enggsajjad/coffeeMachine/BA/coffee/Thesis_Simon/presentation/hardware.tex

\begin{tikzpicture}
    \node[inner sep=0pt] (cm) at (0,0)
    {};
    \node[inner sep=0pt] (pi) at (5,0)
    {};
    \node[inner sep=0pt] (rfid) at (9,0)
    {};
    \node[inner sep=0pt,outer sep=2pt] (buzzer) at (5,-2.5)
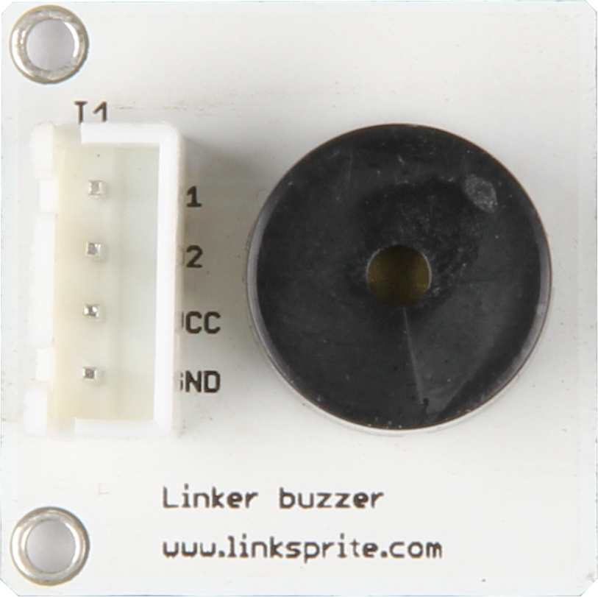
[picture p16: BA/coffee/Thesis_Simon/presentation/images/LK-Buzzer-1.png]
    {};
    \node[rectangle,draw] (tag) at (9,-2.0) {RFID tag};
    \node[inner sep=0pt] (touch) at (5,2.5)
    {};
    \node[inner sep=0pt] (screen) at (5,2.93)
    {};
    \node[rectangle,rounded corners,draw,fill=KITgreen50,align=center,outer sep=2pt] (server) at (9,2.5) {Accounting \\ Server};

    \path[thick,fill=green]
    (pi) edge [<-] node {} (rfid)
    edge [<->] node {} (touch)
    edge [->] node {} (buzzer)
    edge [<->] node[right=1mm] {HTTP} (server)
    edge [<->] node[fill=white,rectangle,draw,align=left] {Adapter \\ Board} (cm)
    (rfid) edge [<-] (tag)
    ;
\end{tikzpicture}
