enggsajjad/coffeeMachine/BA/beamer_template/preambel/cleverrefconfig.tex

\crefname{section}{Abschnitt}{Abschnitte}
\Crefname{section}{Abschnitt}{Abschnitte}

\crefname{subsection}{Unterabschnitt}{Unterabschnitte}
\Crefname{subsection}{Unterabschnitt}{Unterabschnitte}

\crefname{Def}{Definition}{Definitionen}
\Crefname{Def}{Definition}{Definitionen}
\crefname{Def_noBreak}{Definition}{Definitionen}
\Crefname{Def_noBreak}{Definition}{Definitionen}

\crefname{Bsp}{Beispiel}{Beispiele}
\Crefname{Bsp}{Beispiel}{Beispiele}
\crefname{Bsp_noBreak}{Beispiel}{Beispiele}
\Crefname{Bsp_noBreak}{Beispiel}{Beispiele}

\crefname{Bem}{Bemerkung}{Bemerkungen}
\Crefname{Bem}{Bemerkung}{Bemerkungen}
\crefname{Bem_noBreak}{Bemerkung}{Bemerkungen}
\Crefname{Bem_noBreak}{Bemerkung}{Bemerkungen}

\crefname{Sa}{Satz}{Sätze}
\Crefname{Sa}{Satz}{Sätze}
\crefname{Sa_noBreak}{Satz}{Sätze}
\Crefname{Sa_noBreak}{Satz}{Sätze}

\crefname{Lem}{Lemma}{Lemmata}
\Crefname{Lem}{Lemma}{Lemmata}
\crefname{Lem_noBreak}{Lemma}{Lemmata}
\Crefname{Lem_noBreak}{Lemma}{Lemmata}

\crefname{Ko}{Korollar}{Korollare}
\Crefname{Ko}{Korollar}{Korollare}
\crefname{Ko_noBreak}{Korollar}{Korollare}
\Crefname{Ko_noBreak}{Korollar}{Korollare}

\crefname{Erg}{Ergänzung}{Ergänzungen}
\Crefname{Erg}{Ergänzung}{Ergänzungen}
\crefname{Erg_noBreak}{Ergänzung}{Ergänzungen}
\Crefname{Erg_noBreak}{Ergänzung}{Ergänzungen}

\crefname{Bed}{Bedingung}{Bedingungen}
\Crefname{Bed}{Bedingung}{Bedingungen}
\crefformat{Bed}{Bedingung~(#2#1#3)}
\Crefformat{Bed}{Bedingung~(#2#1#3)}
\crefmultiformat{Bed}{Bedingungen~(#2#1#3)}
\Crefmultiformat{Bed}{Bedingungen~(#2#1#3)}
