enggsajjad/coffeeMachine/BA/coffee/Thesis_2017_Karim_Ben_Ammar/images/adapterraspberry.pdf

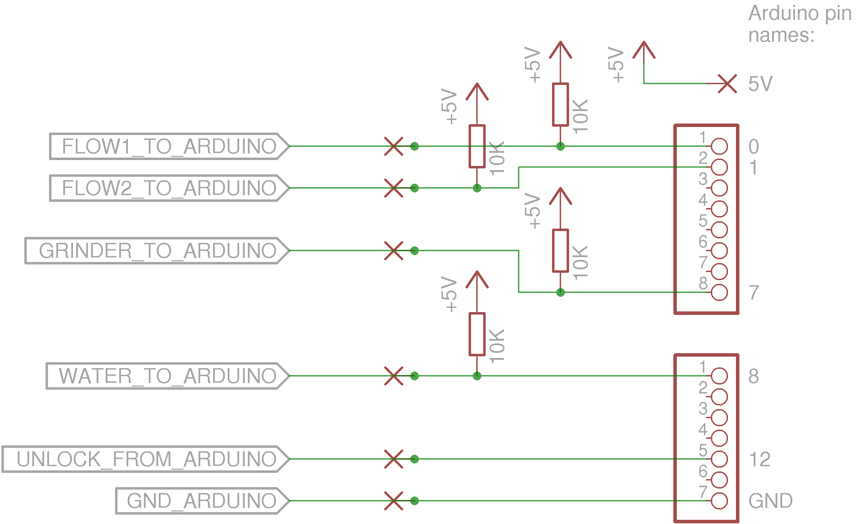
[picture p61: page 1]
