enggsajjad/coffeeMachine/BA/coffee/Thesis_2017_Karim_Ben_Ammar/images/case.pdf

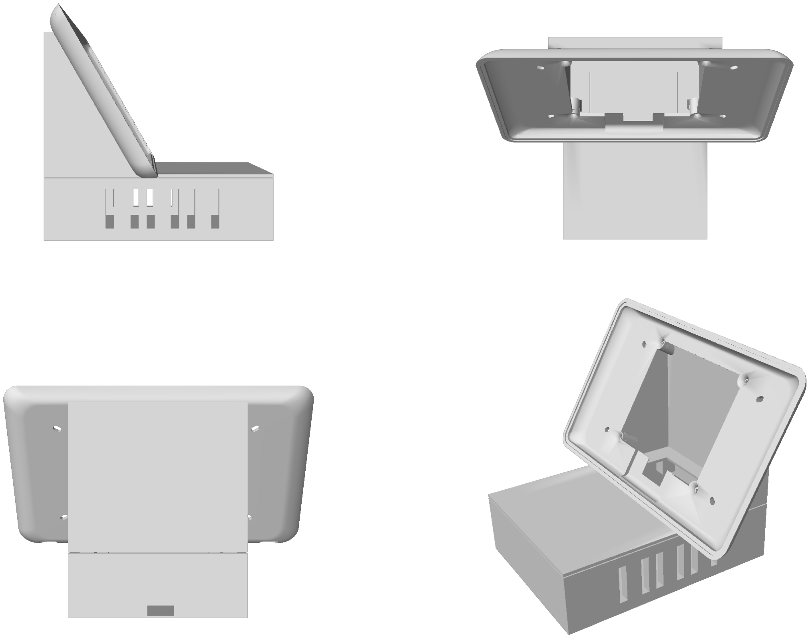
[picture p62: page 1]
