enggsajjad/coffeeMachine/BA/coffee/Thesis_2017_Karim_Ben_Ammar/images/offlineHandlerClasses.pdf

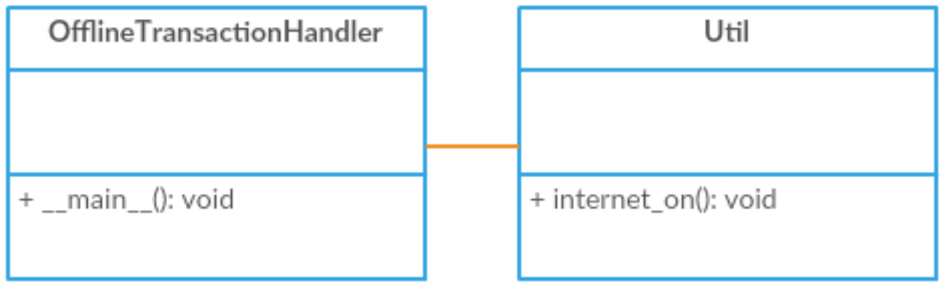
[picture p63: page 1]
