enggsajjad/coffeeMachine/BA/coffee/Thesis_2017_Karim_Ben_Ammar/images/oldPCBSchematic.pdf

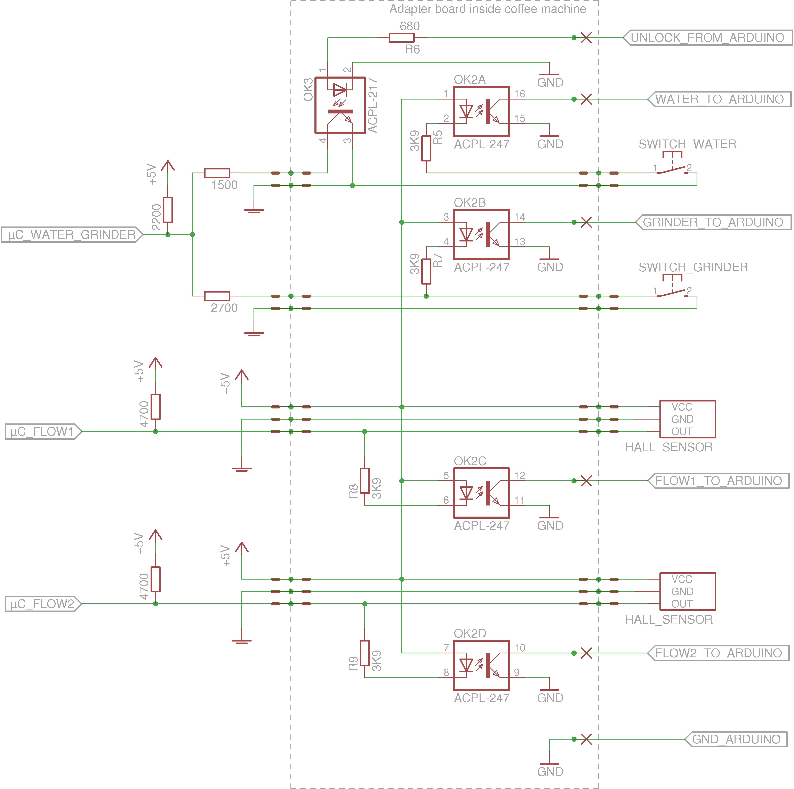
[picture p78: page 1]
