enggsajjad/coffeeMachine/BA/beamer_template/example/ces_title.jpg

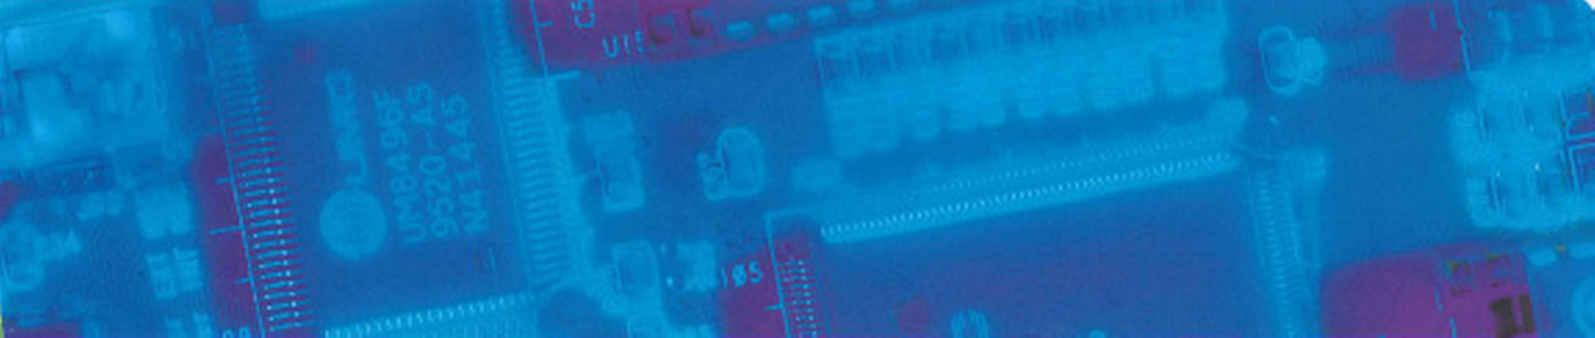
BA/beamer_template/example/ces_title.jpg
