enggsajjad/coffeeMachine/BA/coffee/Thesis_2017_Karim_Ben_Ammar/Code/res/2-sugars-app.jpeg

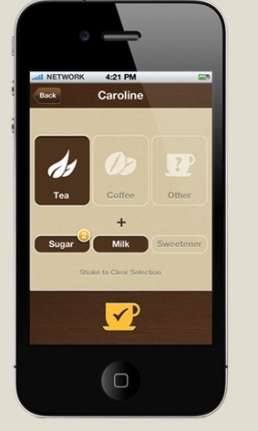
BA/coffee/Thesis_2017_Karim_Ben_Ammar/Code/res/2-sugars-app.jpeg
