enggsajjad/coffeeMachine/BA/coffee/Thesis_2017_Karim_Ben_Ammar/Code/res/check-box-button-clipart-vector-clip-art-online-free.png

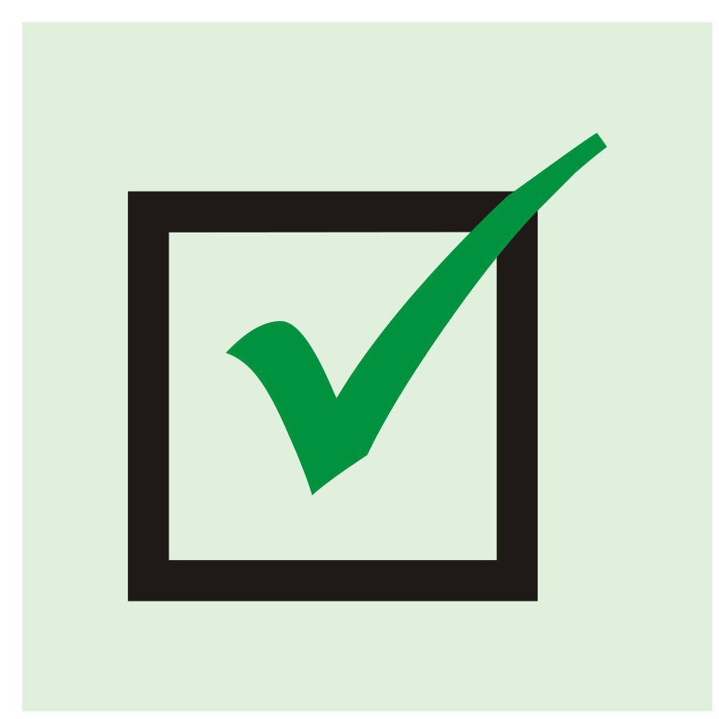
BA/coffee/Thesis_2017_Karim_Ben_Ammar/Code/res/check-box-button-clipart-vector-clip-art-online-free.png
