enggsajjad/coffeeMachine/BA/coffee/Thesis_2017_Karim_Ben_Ammar/Code/res/euro-big-coin-on-a-small-hand_318-37493.jpg

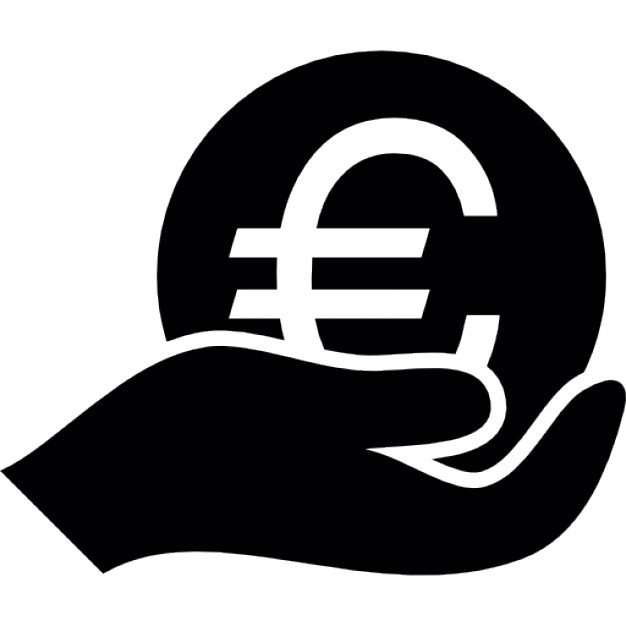
BA/coffee/Thesis_2017_Karim_Ben_Ammar/Code/res/euro-big-coin-on-a-small-hand_318-37493.jpg
