enggsajjad/coffeeMachine/BA/coffee/Thesis_2017_Karim_Ben_Ammar/Code/res/funny-comic-smartphones-1024x951.jpg

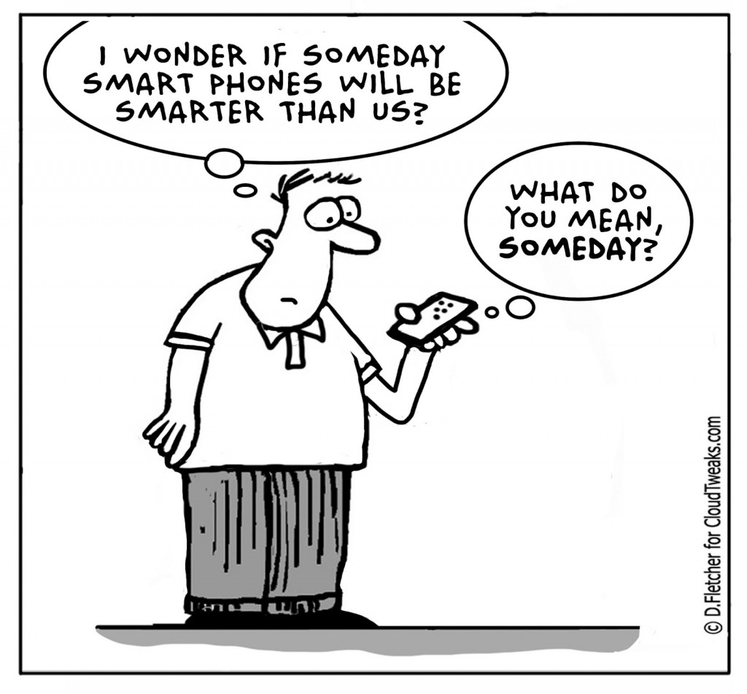
BA/coffee/Thesis_2017_Karim_Ben_Ammar/Code/res/funny-comic-smartphones-1024x951.jpg
