enggsajjad/coffeeMachine/BA/coffee/Thesis_2017_Karim_Ben_Ammar/Code/res/panda_sprite_by_balvick-d7qrors.png

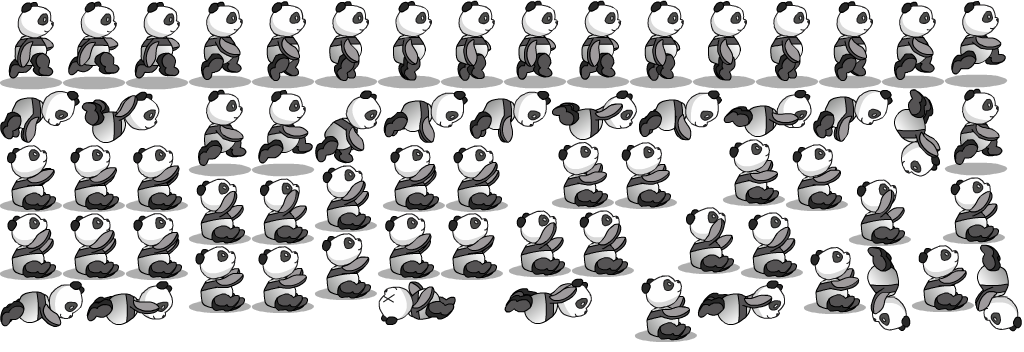
BA/coffee/Thesis_2017_Karim_Ben_Ammar/Code/res/panda_sprite_by_balvick-d7qrors.png
