enggsajjad/coffeeMachine/BA/coffee/Thesis_2017_Karim_Ben_Ammar/Code/res/water-drop-in-a-rounded-square_318-44127.jpg

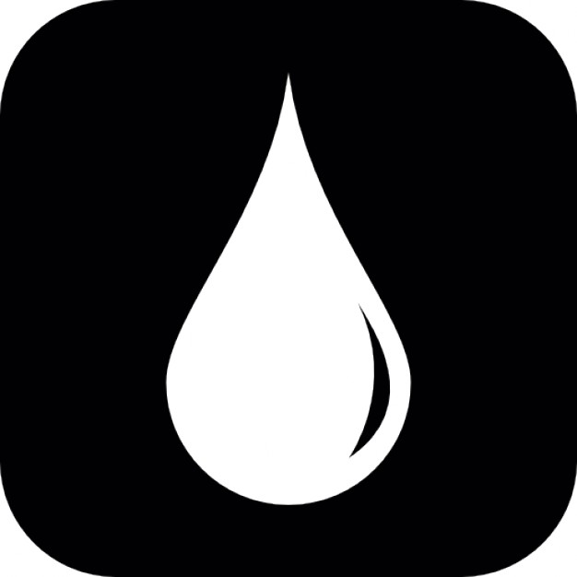
BA/coffee/Thesis_2017_Karim_Ben_Ammar/Code/res/water-drop-in-a-rounded-square_318-44127.jpg
