enggsajjad/coffeeMachine/BA/coffee/Thesis_2017_Karim_Ben_Ammar/images/brew_process.png

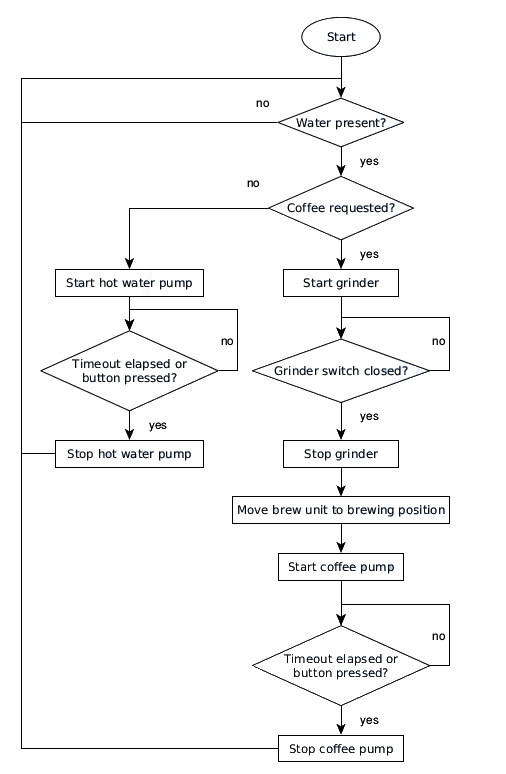
BA/coffee/Thesis_2017_Karim_Ben_Ammar/images/brew_process.png
