enggsajjad/coffeeMachine/BA/coffee/Thesis_2017_Karim_Ben_Ammar/images/communication.jpg

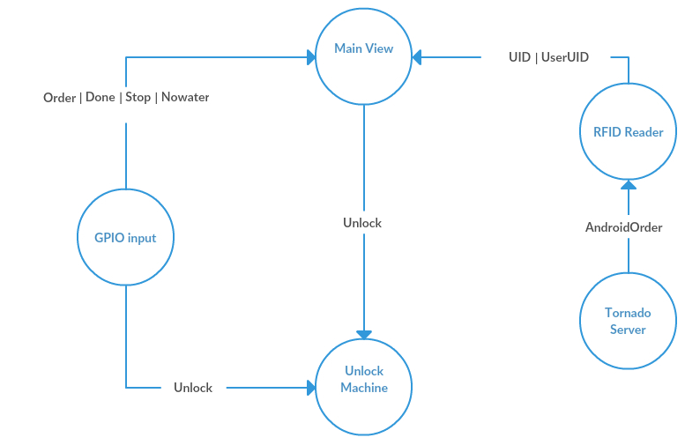
BA/coffee/Thesis_2017_Karim_Ben_Ammar/images/communication.jpg
