enggsajjad/coffeeMachine/BA/coffee/Thesis_2017_Karim_Ben_Ammar/images/config_file.png

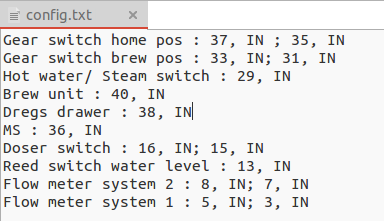
BA/coffee/Thesis_2017_Karim_Ben_Ammar/images/config_file.png
