enggsajjad/coffeeMachine/BA/coffee/Thesis_2017_Karim_Ben_Ammar/images/realFlowSensor.jpg

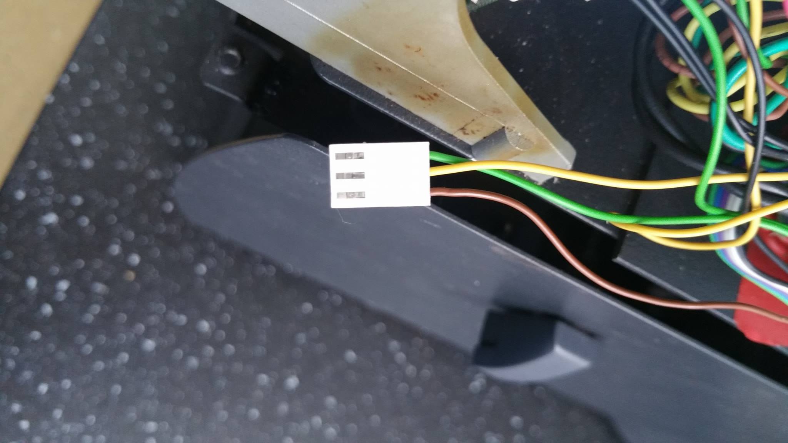
BA/coffee/Thesis_2017_Karim_Ben_Ammar/images/realFlowSensor.jpg
