enggsajjad/coffeeMachine/BA/coffee/Thesis_2017_Karim_Ben_Ammar/images/tornadoServerClasses.png

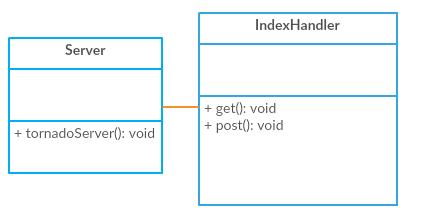
BA/coffee/Thesis_2017_Karim_Ben_Ammar/images/tornadoServerClasses.png
