enggsajjad/coffeeMachine/BA/coffee/Thesis_2017_Karim_Ben_Ammar/images/unlockClasses.png

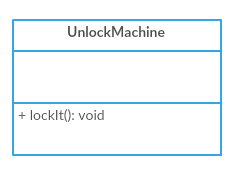
BA/coffee/Thesis_2017_Karim_Ben_Ammar/images/unlockClasses.png
