enggsajjad/coffeeMachine/BA/coffee/Thesis_Simon/coffee-v3/res/coffee-beans.png

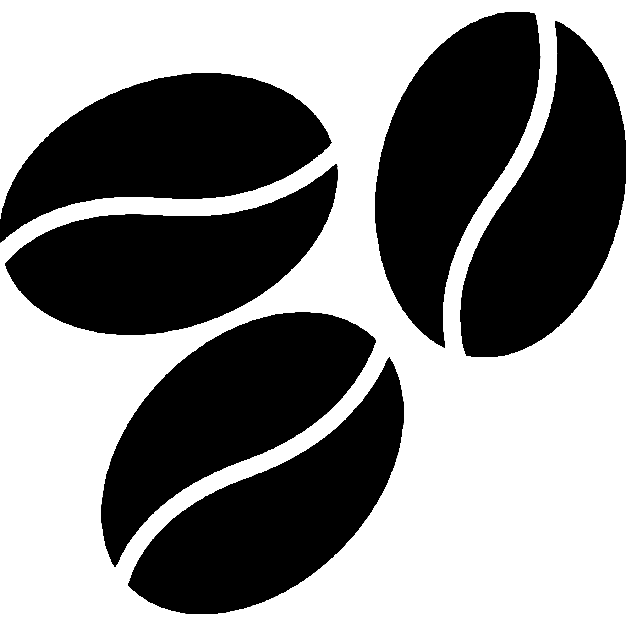
BA/coffee/Thesis_Simon/coffee-v3/res/coffee-beans.png
