enggsajjad/coffeeMachine/BA/coffee/Thesis_Simon/coffee-v3/res/milk-container-checked.png

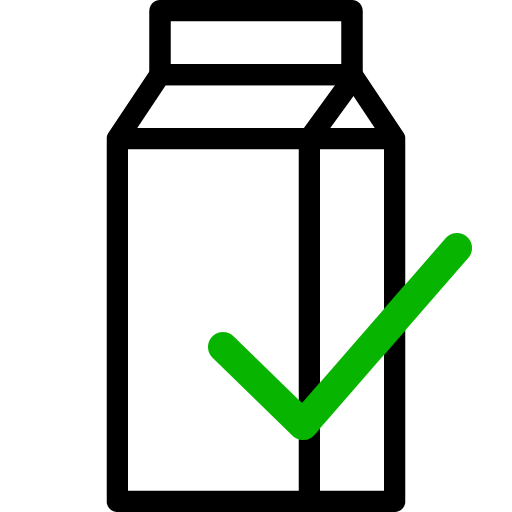
BA/coffee/Thesis_Simon/coffee-v3/res/milk-container-checked.png
