enggsajjad/coffeeMachine/BA/coffee/Thesis_Simon/coffee-v3/res/milk-container-crossed.png

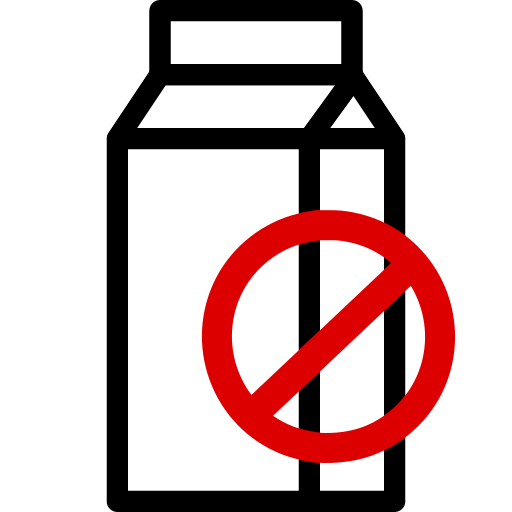
BA/coffee/Thesis_Simon/coffee-v3/res/milk-container-crossed.png
