enggsajjad/coffeeMachine/BA/coffee/Thesis_Simon/coffee-v3/res/water-drop.png

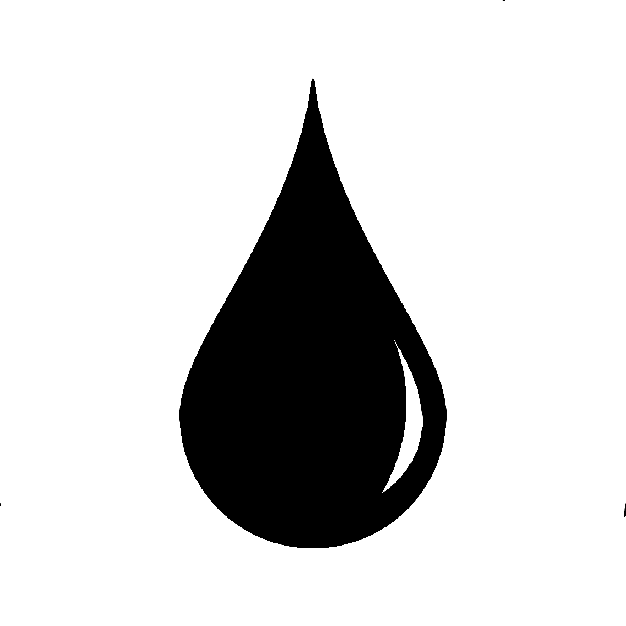
BA/coffee/Thesis_Simon/coffee-v3/res/water-drop.png
