enggsajjad/coffeeMachine/BA/coffee/Thesis_Simon/thesis/images/gui-1.png

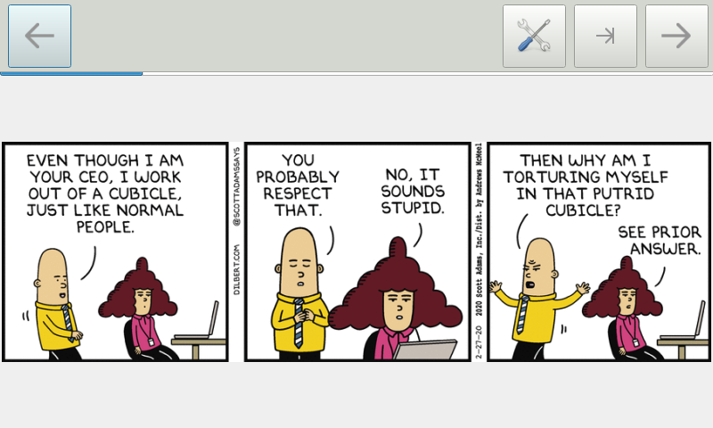
BA/coffee/Thesis_Simon/thesis/images/gui-1.png
