enggsajjad/coffeeMachine/BA/coffee/Thesis_Simon/thesis/images/gui-2.png

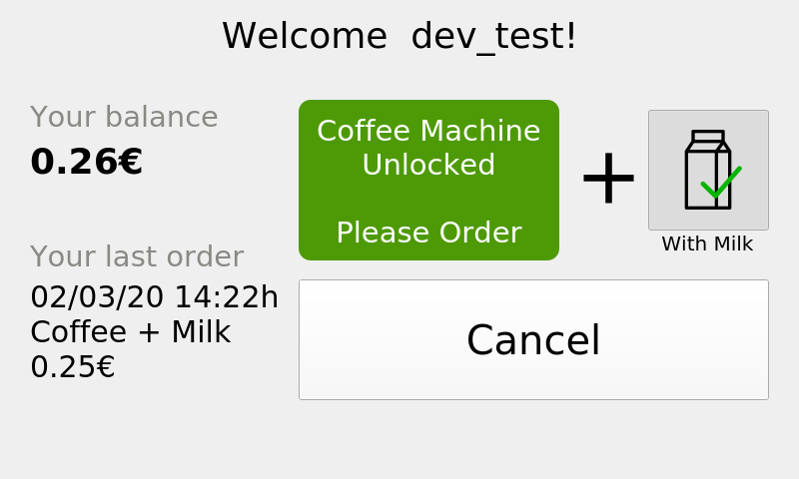
BA/coffee/Thesis_Simon/thesis/images/gui-2.png
