enggsajjad/coffeeMachine/BA/coffee/Thesis_Simon/thesis/images/gui-3.png

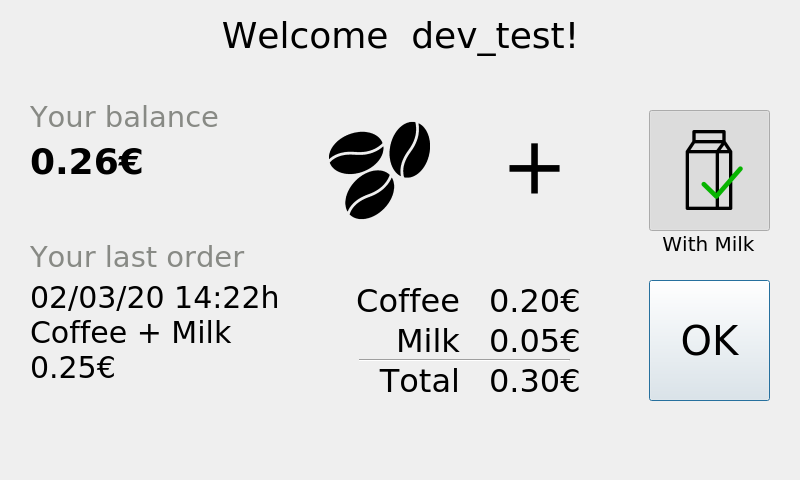
BA/coffee/Thesis_Simon/thesis/images/gui-3.png
