enggsajjad/coffeeMachine/BA/coffee/Thesis_Simon/thesis/images/gui-4.png

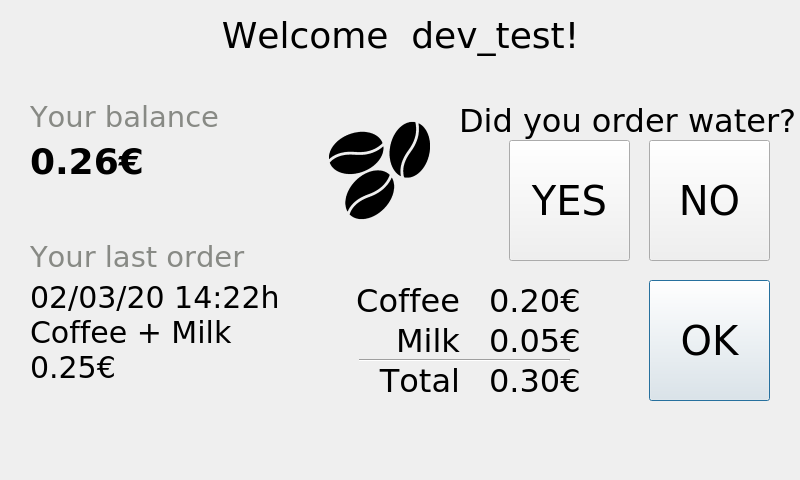
BA/coffee/Thesis_Simon/thesis/images/gui-4.png
