enggsajjad/coffeeMachine/BA/photo_2019-08-08_14-54-59.jpg

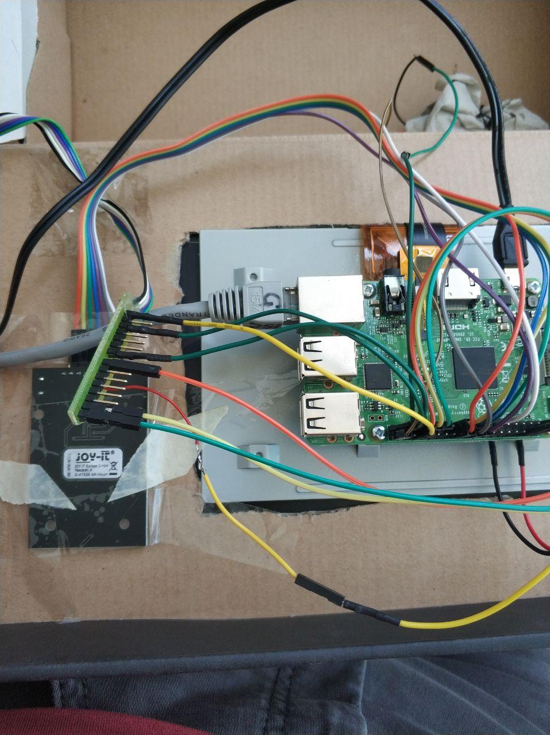
BA/photo_2019-08-08_14-54-59.jpg
