enggsajjad/coffeeMachine/BA/coffee/Thesis_2017_Karim_Ben_Ammar/Code/res/orderCoffee.png

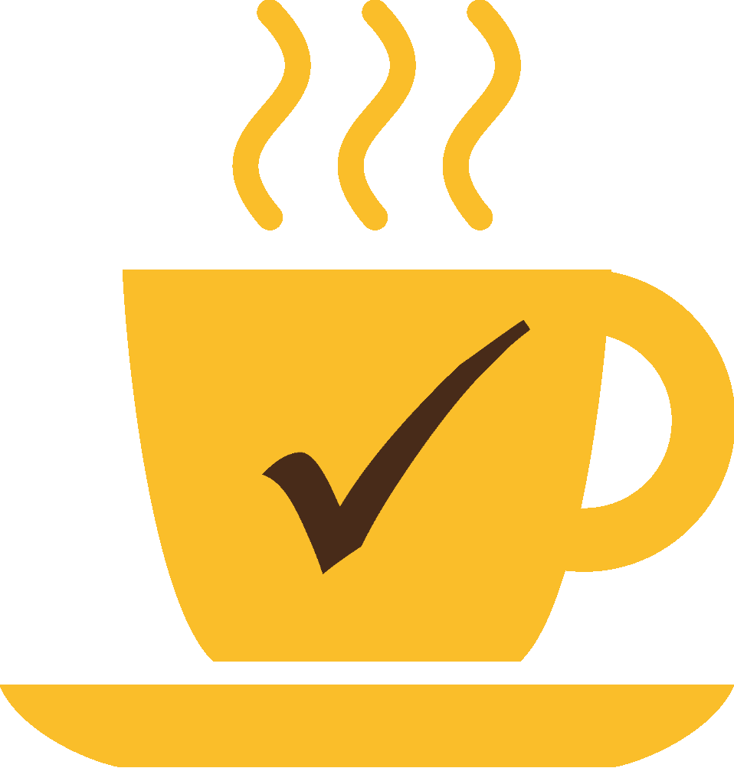
BA/coffee/Thesis_2017_Karim_Ben_Ammar/Code/res/orderCoffee.png
