enggsajjad/coffeeMachine/BA/coffee/Thesis_2017_Karim_Ben_Ammar/BlenderFiles/Bezel.stl

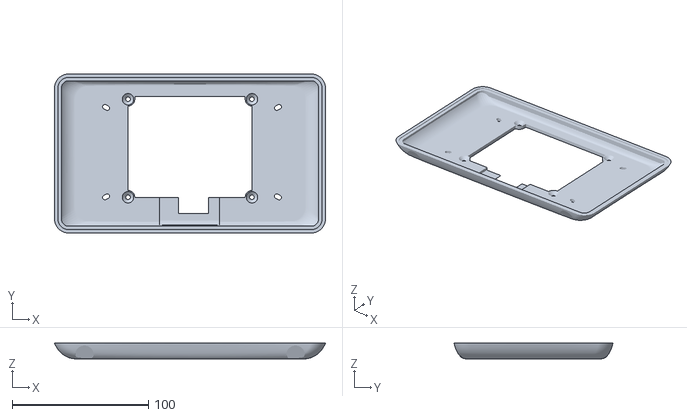
[picture p111: CAD file, 2022-07-01]
BA/coffee/Thesis_2017_Karim_Ben_Ammar/BlenderFiles/Bezel.stl
199.0 x 116.8 x 11.5
