enggsajjad/coffeeMachine/BA/coffee/Thesis_Simon/case/case-v2/case-v2-top.stl

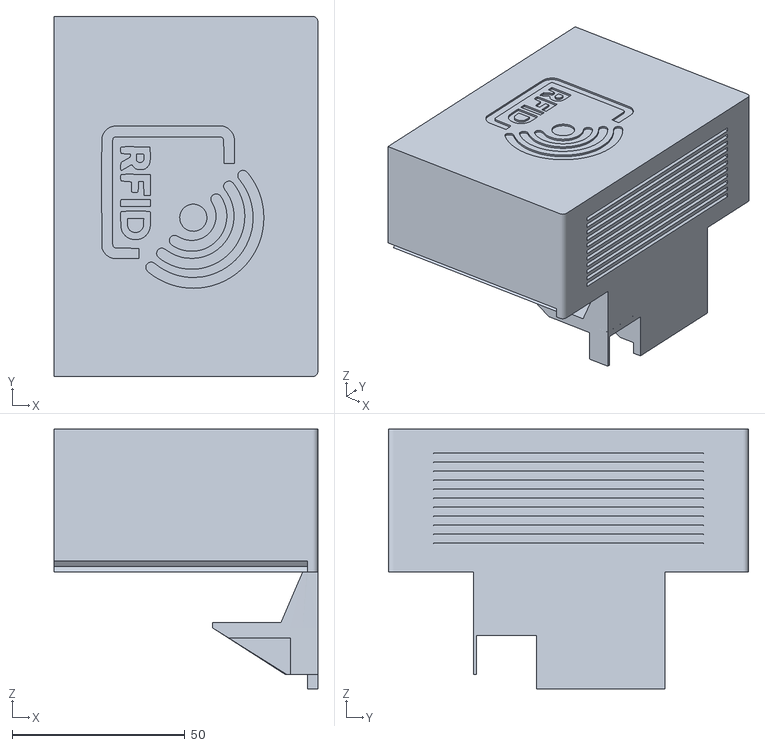
[picture p112: CAD file, 2022-07-01]
BA/coffee/Thesis_Simon/case/case-v2/case-v2-top.stl
76.5 x 104.3 x 75.3
