enggsajjad/coffeeMachine/BA/coffee/Thesis_Simon/case/raspberrypi-case/rpi3_notft_top_2016_12_09_1000.stl

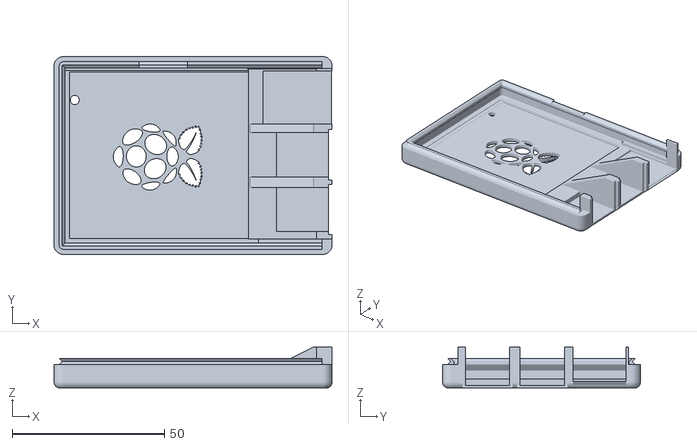
[picture p113: CAD file, 2022-07-01]
BA/coffee/Thesis_Simon/case/raspberrypi-case/rpi3_notft_top_2016_12_09_1000.stl
91.4 x 65.0 x 13.5
