enggsajjad/coffeeMachine/BA/coffee/Thesis_2017_Karim_Ben_Ammar/BlenderFiles/top.stl

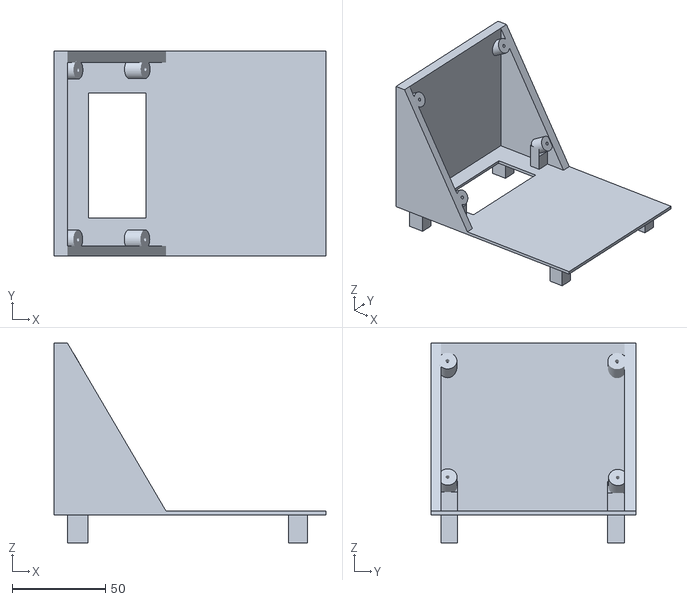
[picture p114: CAD file, 2022-07-01]
BA/coffee/Thesis_2017_Karim_Ben_Ammar/BlenderFiles/top.stl
145.8 x 110.0 x 107.1
