enggsajjad/coffeeMachine/BA/coffee/Thesis_Simon/case/raspberrypi-case/rpi3_notft_bottom_2016_12_09_1000.stl

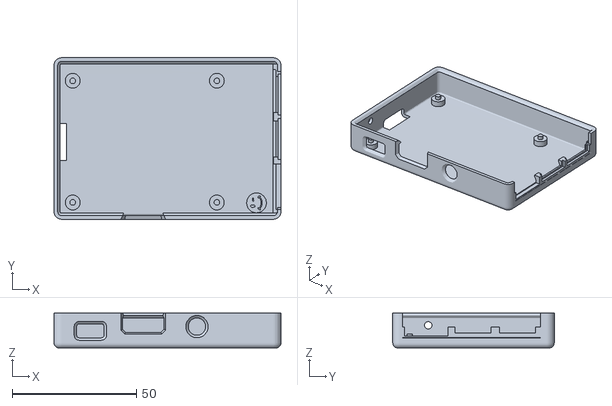
[picture p116: CAD file, 2022-07-01]
BA/coffee/Thesis_Simon/case/raspberrypi-case/rpi3_notft_bottom_2016_12_09_1000.stl
91.4 x 65.0 x 14.1
