enggsajjad/coffeeMachine/BA/coffee/Thesis_2017_Karim_Ben_Ammar/BlenderFiles/base.stl

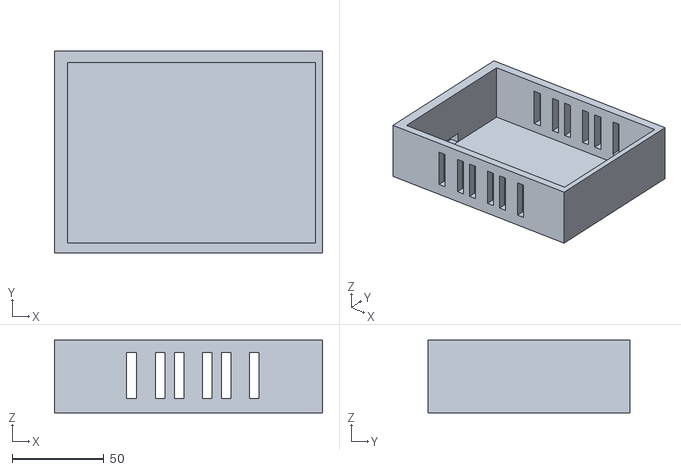
[picture p117: CAD file, 2022-07-01]
BA/coffee/Thesis_2017_Karim_Ben_Ammar/BlenderFiles/base.stl
145.8 x 110.0 x 39.5
