enggsajjad/coffeeMachine/BA/coffee/Thesis_Simon/case/case-v2/case-v2-bottom.stl

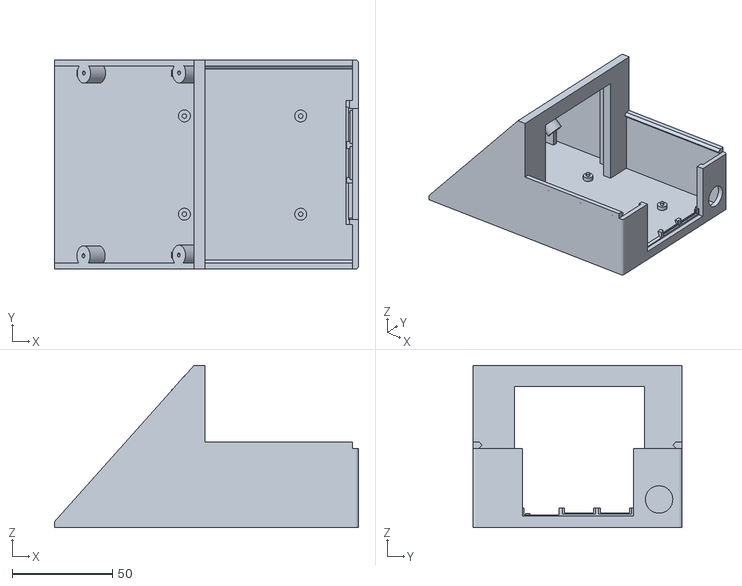
[picture p118: CAD file, 2022-07-01]
BA/coffee/Thesis_Simon/case/case-v2/case-v2-bottom.stl
151.6 x 104.3 x 81.0
