enggsajjad/coffeeMachine/BA/coffee/Thesis_Simon/case/case-v2/case-v2-top-optimized.stl

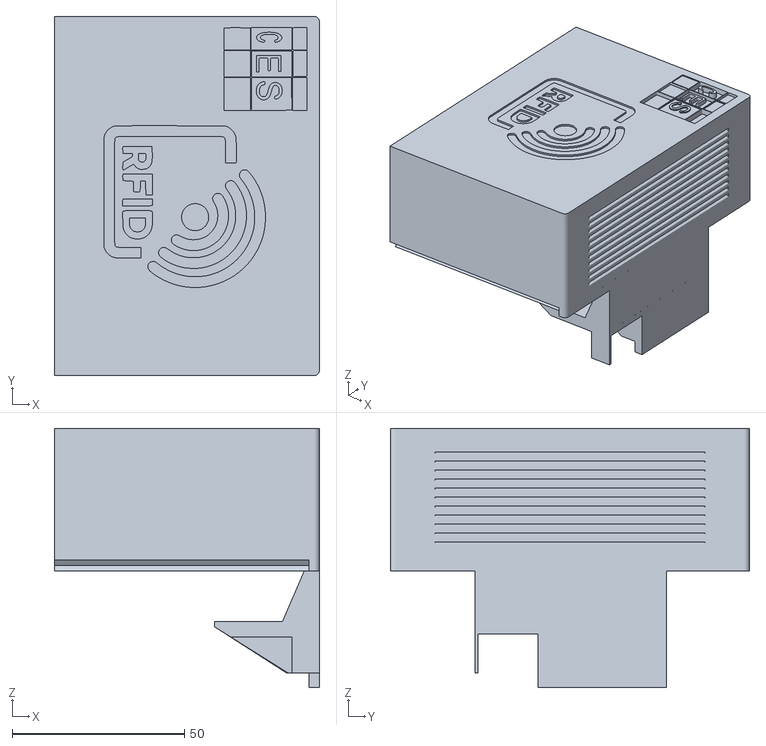
[picture p119: CAD file, 2022-07-01]
BA/coffee/Thesis_Simon/case/case-v2/case-v2-top-optimized.stl
77.0 x 104.3 x 75.3
