enggsajjad/coffeeMachine/BA/coffee/Thesis_Simon/case/case-v1/base2.stl

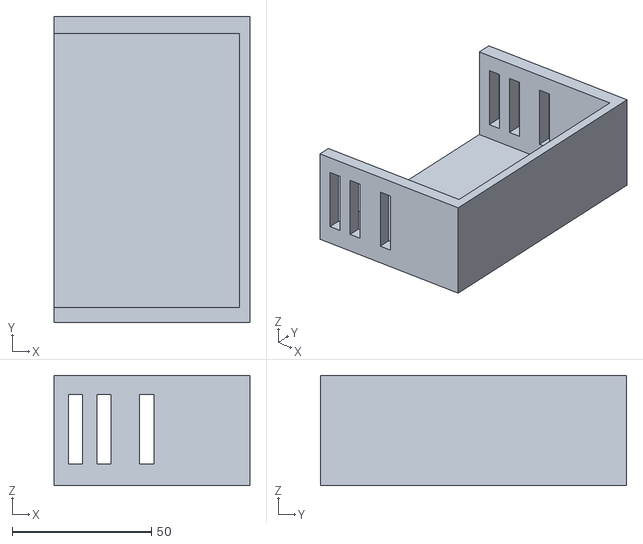
[picture p120: CAD file, 2022-07-01, an earlier design]
BA/coffee/Thesis_Simon/case/case-v1/base2.stl
70.3 x 110.0 x 39.5
