enggsajjad/coffeeMachine/BA/coffee/Thesis_Simon/case/case-v1/base1.stl

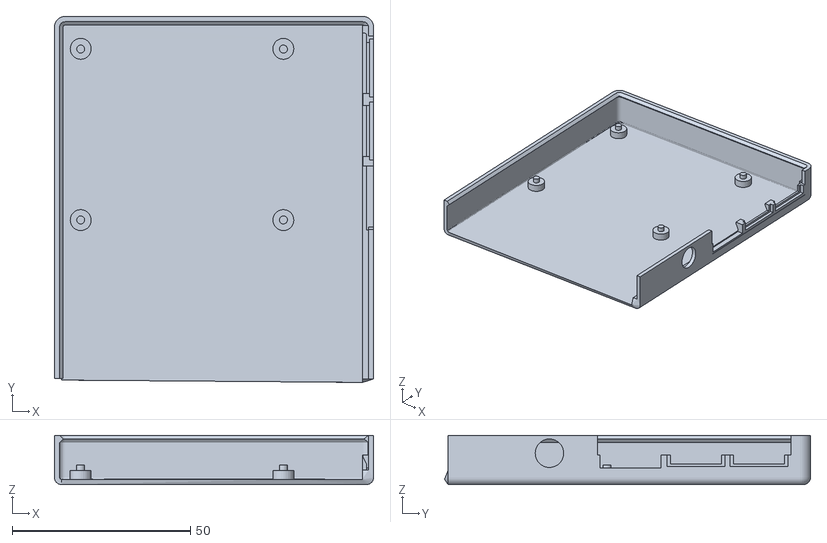
[picture p121: CAD file, 2022-07-01, an earlier design]
BA/coffee/Thesis_Simon/case/case-v1/base1.stl
89.6 x 102.7 x 13.8
