enggsajjad/coffeeMachine/BA/coffee/Thesis_Simon/case/case-v1/case.stl

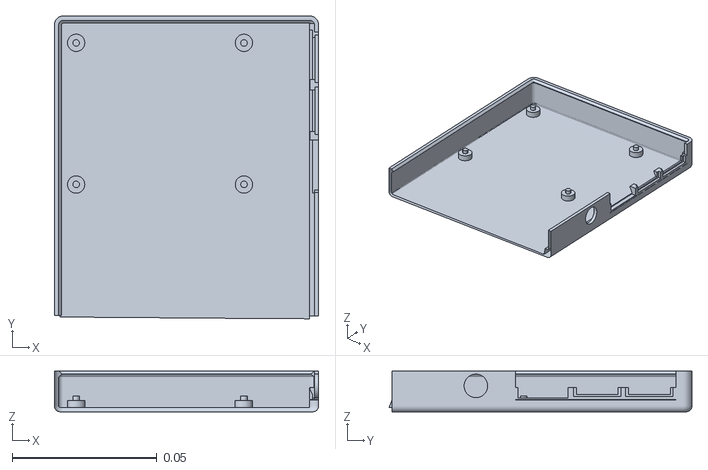
[picture p122: CAD file, 2022-07-01, an earlier design]
BA/coffee/Thesis_Simon/case/case-v1/case.stl
0.0914 x 0.105 x 0.0141
