enggsajjad/coffeeMachine/(list of files, cad)

Other CAD files:
BA/coffee/Thesis_Simon/case/case-v1/base-rail-left.blend
BA/coffee/Thesis_Simon/case/case-v1/base.blend
BA/coffee/Thesis_Simon/case/case-v1/case.blend
BA/coffee/Thesis_Simon/case/case-v2/case-v2-corrected-top-with-ces-optimized.blend
BA/coffee/Thesis_Simon/case/case-v2/case-v2-corrected-top-with-ces.blend
BA/coffee/Thesis_Simon/case/case-v2/case-v2-corrected-top.blend
BA/coffee/Thesis_Simon/case/case-v2/case-v2-failed-top.blend
