enggsajjad/coffeeMachine/BA/coffee/Thesis_Simon/presentation/build/presentation-draft-r1.pdf

# Improving Usability and Reliability of an IoT-based Controller

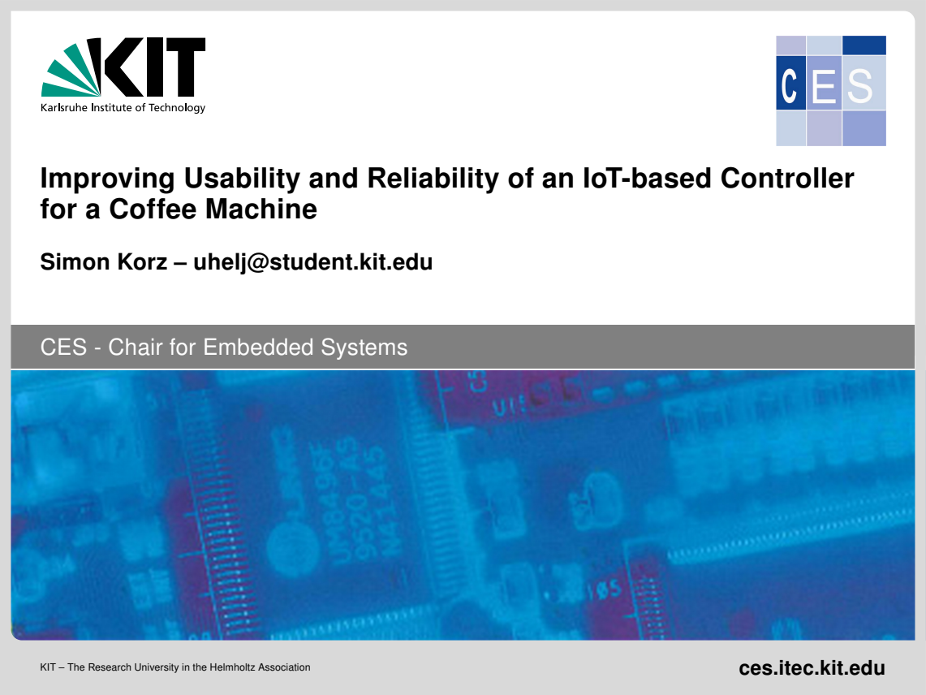
[picture p123: page 1]
Simon Korz - Improving Usability and Reliability of an IoT-based Controller for a Coffee Machine; KIT – The Research University in the Helmholtz Association; ces.itec.kit.edu

for a Coffee Machine

Simon Korz – uhelj@student.kit.edu

CES - Chair for Embedded Systems

# Introducing the Topic

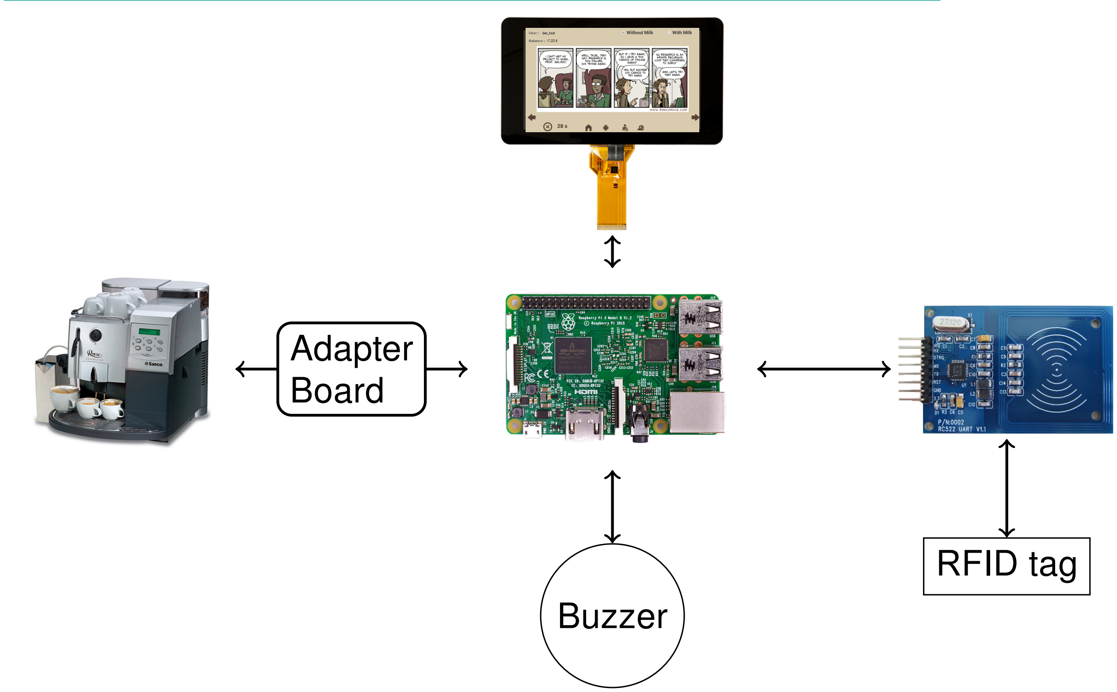
[picture p124: figure]
Buzzer; RFID tag; Adapter Board

1/26 | 20-03-2020 | Simon Korz - Improving Usability and Reliability of an IoT-based Controller for a Coffee Machine

# Goals

2/26 | 20-03-2020 | Simon Korz - Improving Usability and Reliability of an IoT-based Controller for a Coffee Machine

# Improve Usability and Reliability by fixing bugs redesigning the UI adding new features

# Structure of this Talk

3/26 | 20-03-2020 | Simon Korz - Improving Usability and Reliability of an IoT-based Controller for a Coffee Machine

# Introduction

# Problem Analysis

# New Design & Architecture

# Results

# Part 1

4/26 | 20-03-2020 | Simon Korz - Improving Usability and Reliability of an IoT-based Controller for a Coffee Machine

# Introduction

# Usability

5/26 | 20-03-2020 | Simon Korz - Improving Usability and Reliability of an IoT-based Controller for a Coffee Machine

# "extent to which a system, product or service can be

# used by specified users

# to achieve specified goals

# with effectiveness efficiency satisfaction

# in a specified context of use"

# Available Sensors

6/26 | 20-03-2020 | Simon Korz - Improving Usability and Reliability of an IoT-based Controller for a Coffee Machine

# connected via GPIO

# water flow

5s-30s

# variable frequency, proportional to flow speed

# grinder

# less 1s irregular pattern

# water level/blocking

### water tank

### Adapter

### controller

# input AND output

# Accounting Server

7/26 | 20-03-2020 | Simon Korz - Improving Usability and Reliability of an IoT-based Controller for a Coffee Machine

# Treasury, keeps record of Transactions (withdrawals, deposits, coffee bought) Users RFIDs

# Technical: MySQL database Apache + PHP webserver

# System Details

8/26 | 20-03-2020 | Simon Korz - Improving Usability and Reliability of an IoT-based Controller for a Coffee Machine

# Broadcom BCM2837, 4 core Cortex-A53 (ARMv8) 64-bit SoC @ 1.2GHz 1GB LPDDR2 SDRAM OS: Raspbian GNU/Linux (Debian 10 Buster) Language: Python GUI: PyQt5

# Part 2

9/26 | 20-03-2020 | Simon Korz - Improving Usability and Reliability of an IoT-based Controller for a Coffee Machine

# Problem Analysis

# 21 Issues Identified

10/26 20-03-2020 Simon Korz - Improving Usability and Reliability of an IoT-based Controller for a Coffee Machine

# GUI related

# size of controls focus on information timeouts

# Bugs

# unresponsive GUI/RFID reader coffee not registered or recognized as hot water offline orders not synchronized

# Missing features

# support for new KIT-Card dispensing limit various buzzer sounds

# GUI Problems

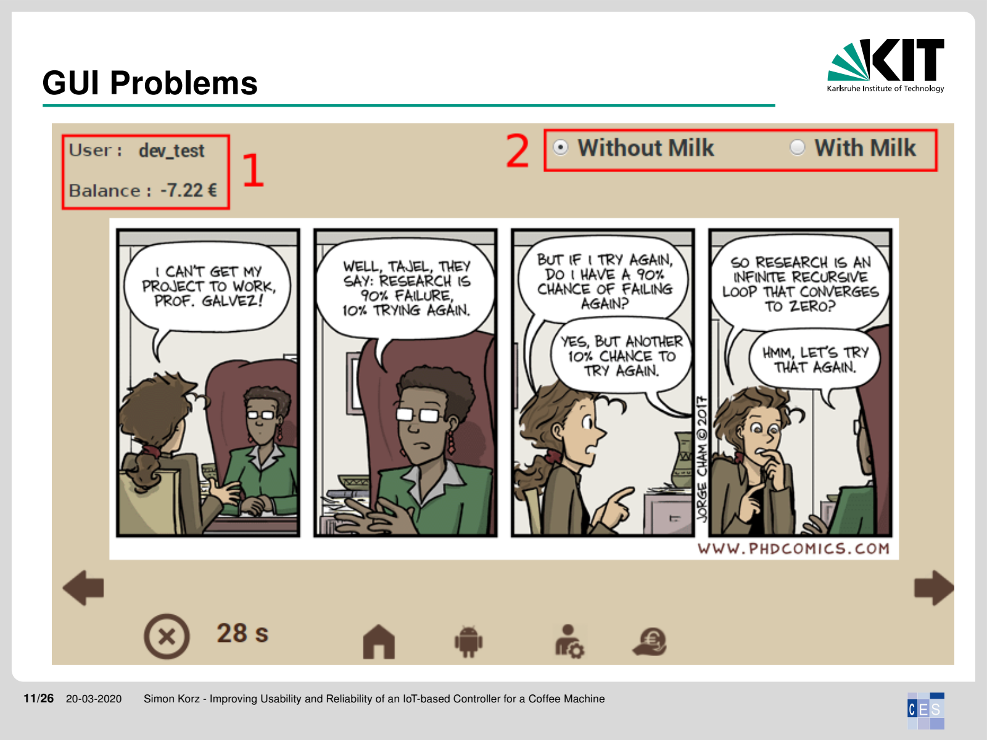
[picture p125: page 12]

11/26 20-03-2020 Simon Korz - Improving Usability and Reliability of an IoT-based Controller for a Coffee Machine

# Unfinished Case

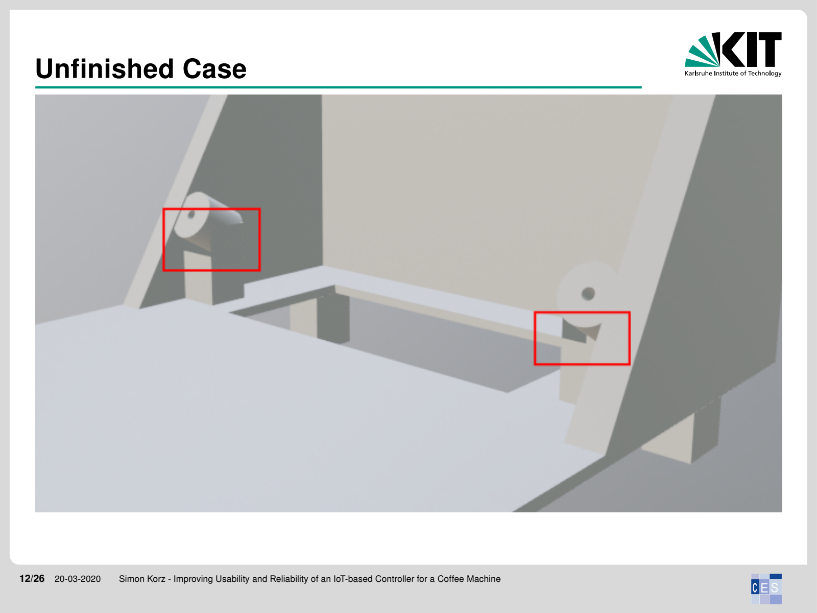
[picture p126: page 13]

12/26 20-03-2020 Simon Korz - Improving Usability and Reliability of an IoT-based Controller for a Coffee Machine

# Code Quality

13/26 20-03-2020 Simon Korz - Improving Usability and Reliability of an IoT-based Controller for a Coffee Machine

### def p r i nt L o g ( a r r a y ) :

i f not os . path . i s f i l e ( " / home / p i / CoffeeMachine / UI / maintenance . t x t " ) :

### global p r e v i o u sG r i n d e r

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

i f os . path . i s f i l e ( " / home / p i / CoffeeMachine / UI / o rde r . t x t " ) : w it h open( " / home / p i / CoffeeMachine / UI / o rde r . t x t " , " r " ) as j : temp = j . r e a d l i n e ( ) i f temp == " wate r \ n " : os . remove ( " / home / p i / CoffeeMachine / UI / o rde r . t x t " ) w it h open( " / home / p i / CoffeeMachine / UI / o rde r . t x t " , " a+ " ) as f : f . w r i t e ( " c off e e \ n " ) f . c lo se ( ) w it h open( " / home / p i / CoffeeMachine / UI / stop . t x t " , " a " ) as f : pass c u r r e ntO r d e r = ’ c off e e ’ p r e v i o u sG r i n d e r = 1 e l i f GPIO . inpu t ( g r i n d e rP i n ) == 1 and p r e v i o u sG r i n d e r == 0: p r e v i o u sG r i n d e r = 1

e l i f not (GPIO . inpu t ( wate rFlow1Pin ) == previousWaterFLow1 ) or not (GPIO . inpu t ( wate rFlow2Pin ) ==

### previousWaterFLow2 ) : previousWaterFLow2 = GPIO . inpu t ( wate rFlow2Pin ) previousWaterFLow1 = GPIO . inpu t ( wate rFlow1Pin ) i d l eC o u nt = 0

i f not os . path . i s f i l e ( " / home / p i / CoffeeMachine / UI / o rde r . t x t " ) :

### w it h open( " / home / p i / CoffeeMachine / UI / o rde r . t x t " , " a+ " ) as f : f . w r i t e ( " wate r \ n " ) c u r r e ntO r d e r = ’ wate r ’

e l i f not os . path . i s f i l e ( " / home / p i / CoffeeMachine / UI / unlo c k . t x t " ) and os . path . i s f i l e ( " / home / p i /

### CoffeeMachine / UI / o rde r . t x t " ) and c u r r e ntO r d e r == ’ wate r ’ : w it h open( " / home / p i / CoffeeMachine / UI / unlo c k . t x t " , " a " ) as f : pass

# Part 3

14/26 20-03-2020 Simon Korz - Improving Usability and Reliability of an IoT-based Controller for a Coffee Machine

# New Design & Architecture

# New GUI

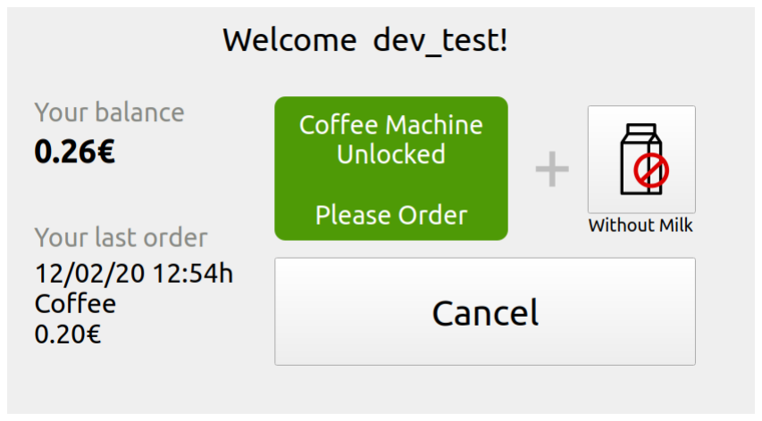
[picture p127: figure]

15/26 20-03-2020 Simon Korz - Improving Usability and Reliability of an IoT-based Controller for a Coffee Machine

# focus on important information large buttons, suitable for touch visual feedback for each step in ordering process

# The State Machine I

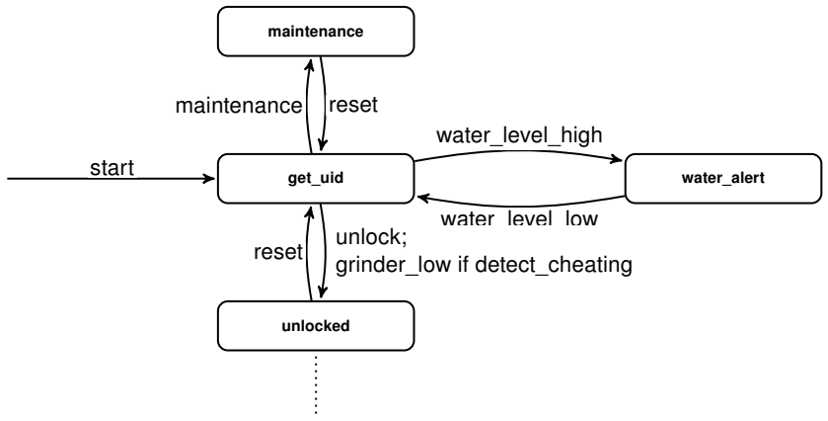
[picture p128: figure]
maintenance; get_uid; water_alert; unlocked; start; water_level_low; water_level_high; unlock; grinder_low if detect_cheating reset; reset

16/26 20-03-2020 Simon Korz - Improving Usability and Reliability of an IoT-based Controller for a Coffee Machine

# The State Machine II

get_uid | unlocked

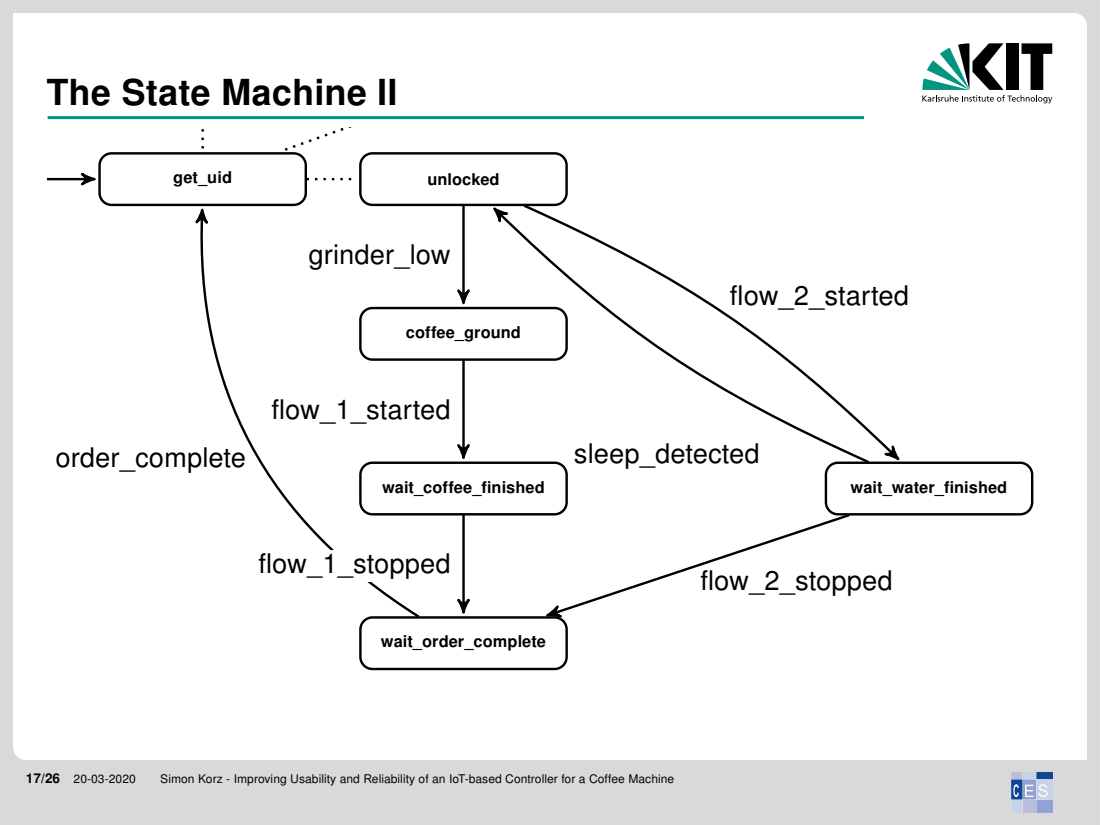
[picture p129: page 18]
Simon Korz - Improving Usability and Reliability of an IoT-based Controller for a Coffee Machine; coffee_ground; wait_coffee_finished; wait_water_finished; wait_order_complete; grinder_low; flow_2_started; order_complete; flow_1_started; flow_1_stopped; flow_2_stopped; sleep_detected

# Leveraging multiple CPU cores

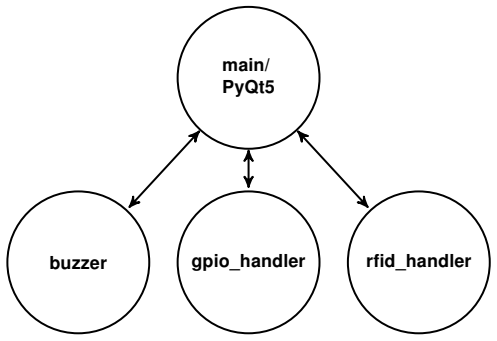
[picture p130: figure]
main/ PyQt5; buzzer; gpio_handler; rfid_handler

18/26 20-03-2020 Simon Korz - Improving Usability and Reliability of an IoT-based Controller for a Coffee Machine

# 4 cores available bidirectional pipes predefined messages

e.g, CMD_PAUSE,
CMD_RESUME,
CMD_LOCK,

# E_GOT_ID

# Changes in GPIO handling

19/26 20-03-2020 Simon Korz - Improving Usability and Reliability of an IoT-based Controller for a Coffee Machine

# callbacks instead of polling Using pigpio library instead of RPi.GPIO

# supports callbacks through hardware interrupts noise filters

# 3D-Printed Case

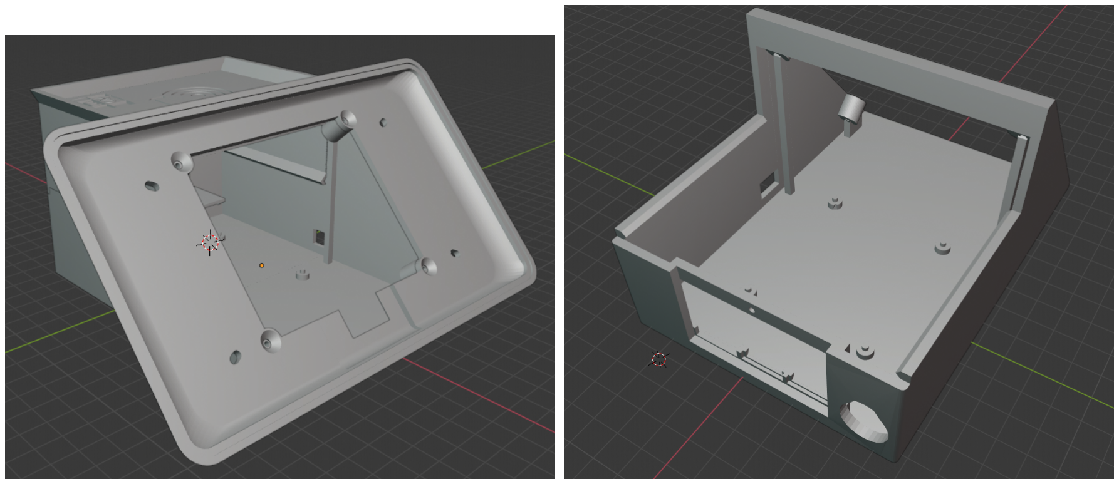
[picture p131: figure]

20/26 20-03-2020 Simon Korz - Improving Usability and Reliability of an IoT-based Controller for a Coffee Machine

# Difficulties: Non-manifold geometry, "not solid" Raspberry Pi held in place without screws

# Part 4

21/26 20-03-2020 Simon Korz - Improving Usability and Reliability of an IoT-based Controller for a Coffee Machine

# Results

# Printing Costs

22/26 20-03-2020 Simon Korz - Improving Usability and Reliability of an IoT-based Controller for a Coffee Machine

# Resin tank: €65.45 1L grey resin: €160.65

# resin tank €65.45 + resin €160.65

1000ml | = €0.2261/ml

# Top part: 90.79ml => €20,53 Bottom part: 150.08ml => €33.93 Screen frame: 53.60+ml => €12.12 Total €66.58

# Accumulated cost estimate €300

# Reduced CPU usage

23/26 20-03-2020 Simon Korz - Improving Usability and Reliability of an IoT-based Controller for a Coffee Machine

# Measurements made with ps command one hour after boot

%CPU | %memory | python module

# Old

98.1 | 1.8 | inputGPIO.py (GPIO & buzzer)
12.4 | 2.1 | inputGPIO.py (RFID)
0.1 | 10.2 | main.py (GUI)
0.0 | 1.6 | inputGPIO.py (locking)

# New

5.9 | 0.1 | pigpiod (GPIO)
16.3 | 3.9 | main.py (RFID)
0.7 | 10.6 | main.py (GUI)
0.4 | 4.6 | main.py (GPIO & locking)
0.0 | 4.4 | main.py (buzzer)

% CPU is the “cpu utilization of the process in "##.#" format. Currently, it is the CPU time used divided by the time the process has been running (cputime/realtime ratio), expressed as a percentage.",
% memory is the “ratio of the process’s resident set size to the physical memory on the machine, expressed

# as a percentage." [ps(1) manpage]

# Improved Usability and Reliability

24/26 20-03-2020 Simon Korz - Improving Usability and Reliability of an IoT-based Controller for a Coffee Machine

# Applied usability requirements 18/21 issues directly address usability system observed to run for 1 month without restart positive user feedback

# Part 5

25/26 20-03-2020 Simon Korz - Improving Usability and Reliability of an IoT-based Controller for a Coffee Machine

# Questions

# 3D-Printed Case

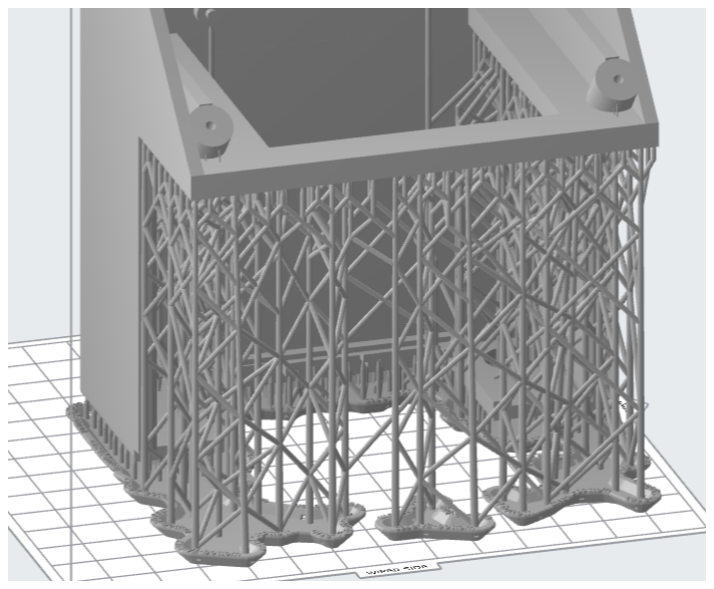
[picture p132: figure]

26/26 20-03-2020 Simon Korz - Improving Usability and Reliability of an IoT-based Controller for a Coffee Machine
