enggsajjad/coffeeMachine/BA/coffee/Thesis_2017_Karim_Ben_Ammar/images/pcb.pdf

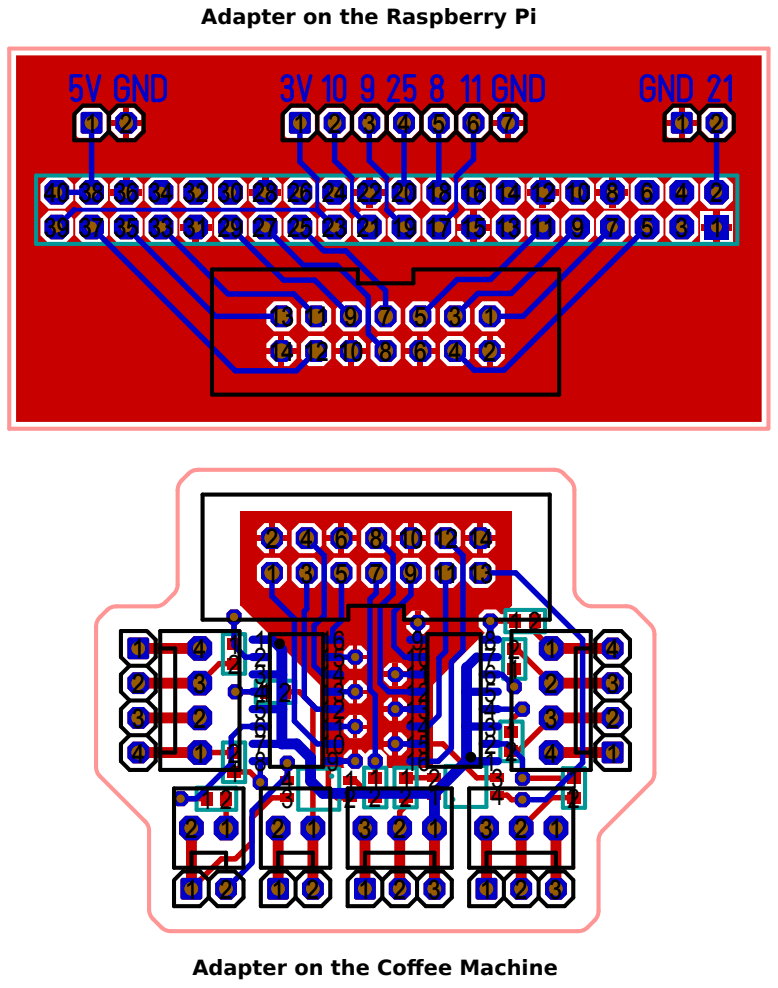
[picture p133: page 1]

Adapter on the Raspberry Pi

Adapter on the Coffee Machine
