enggsajjad/coffeeMachine/BA/coffee/Thesis_2017_Karim_Ben_Ammar/images/pcbSchematic.pdf

## NEWSIG2d_SAECO NEWSIG2c_SAECO_GND

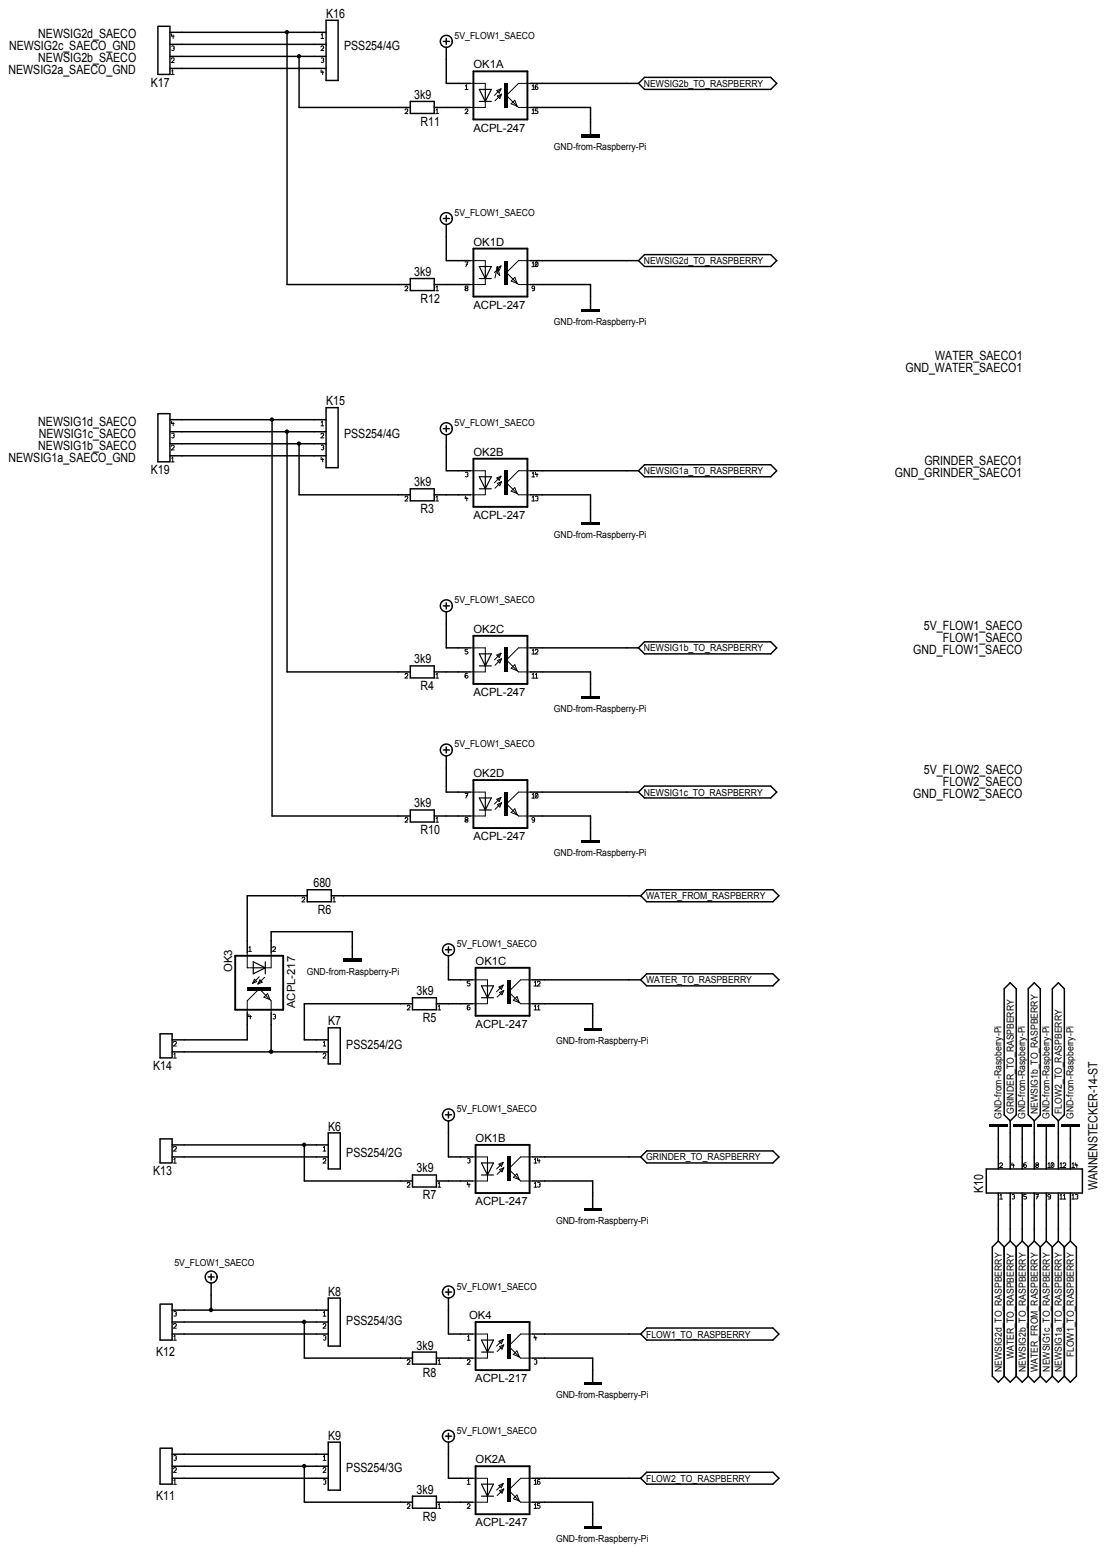
[picture p134: page 1]

GND-from-Raspberry-Pi

ACPL-217
