enggsajjad/coffeeMachine/BA/coffee/Thesis_2017_Karim_Ben_Ammar/CESlogo.pdf

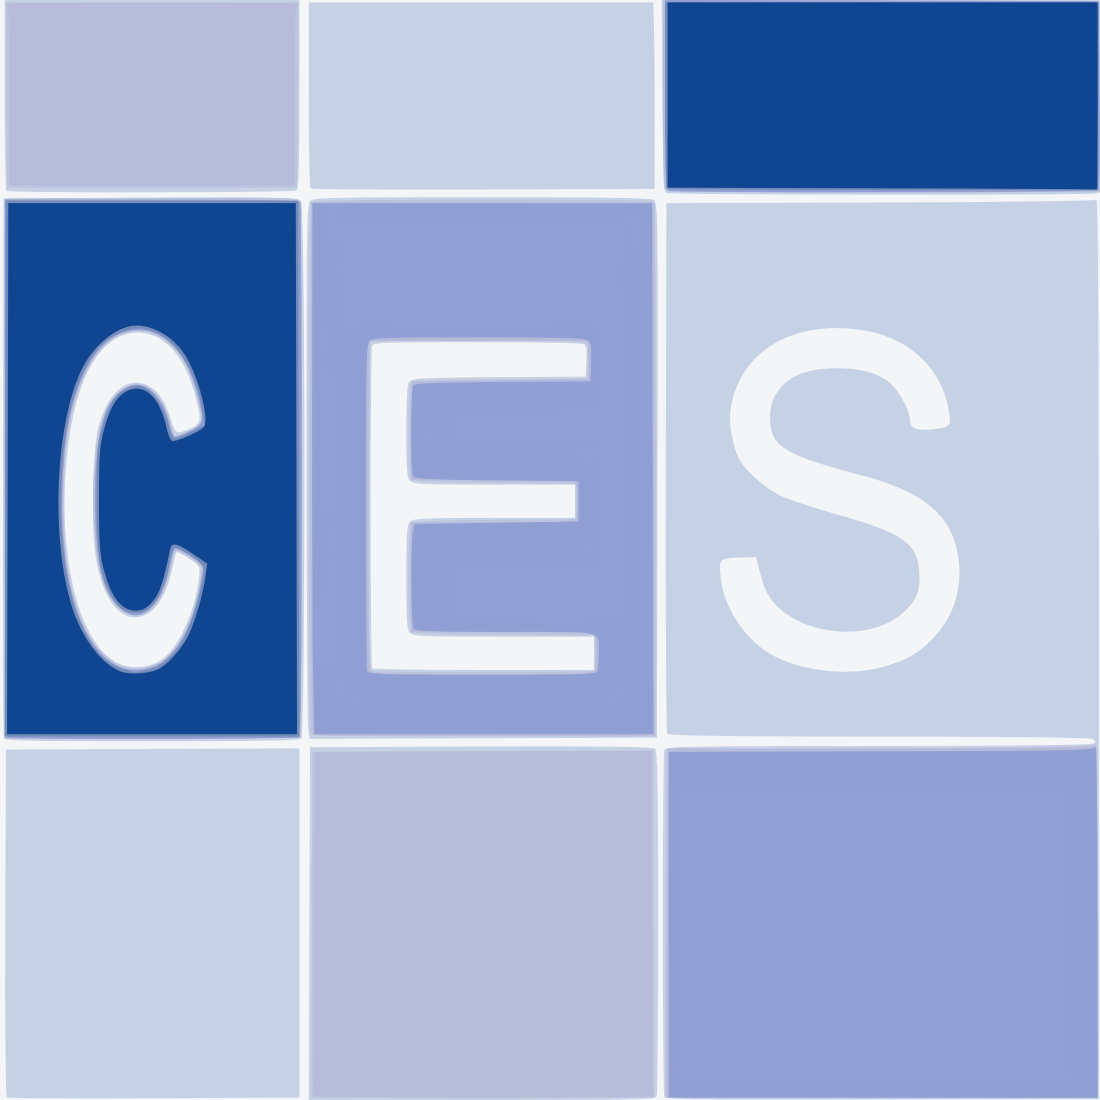
[picture p135: page 1]
