enggsajjad/coffeeMachine/BA/coffee/Thesis_Simon/buzzer-sheet.pdf

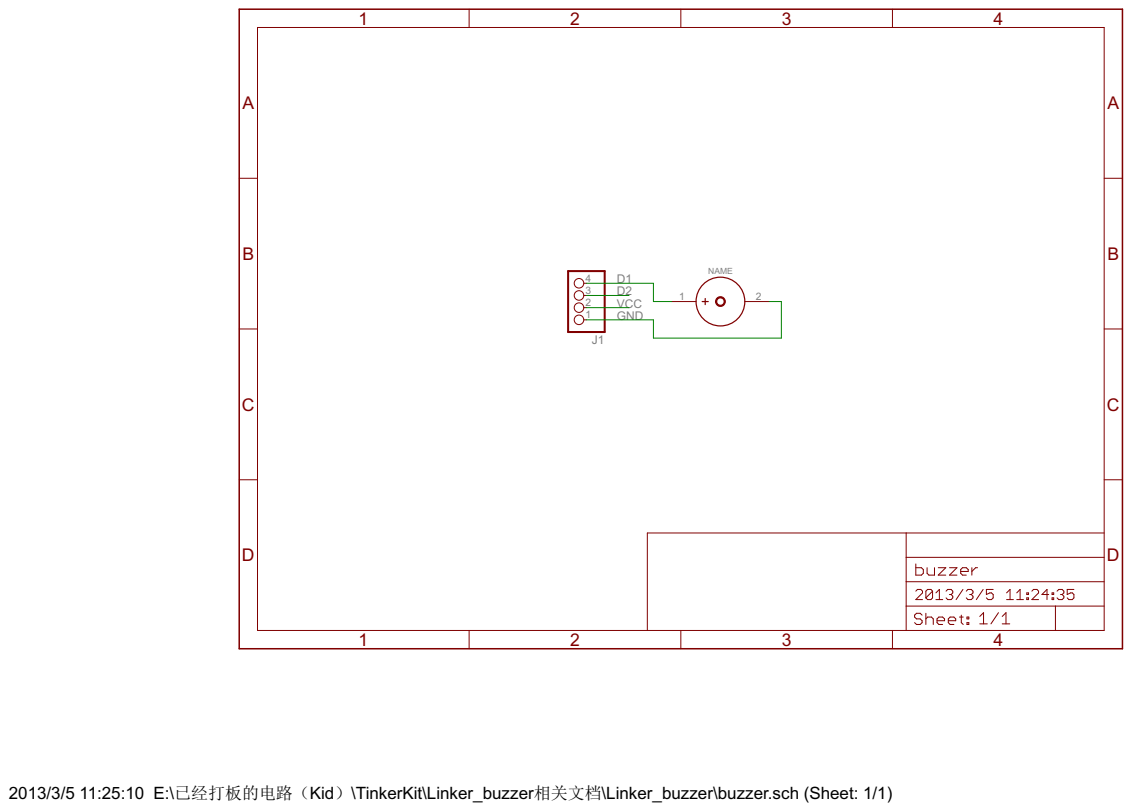
[picture p136: page 1]

2013/3/5 11:25:10 E:\已经打板的电路（Kid）\TinkerKit\Linker_buzzer相关文档\Linker_buzzer\buzzer.sch (Sheet: 1/1)
