enggsajjad/coffeeMachine/BA/coffee/Thesis_Simon/presentation/KIT/kit_logo_de_1c_schwarz.pdf

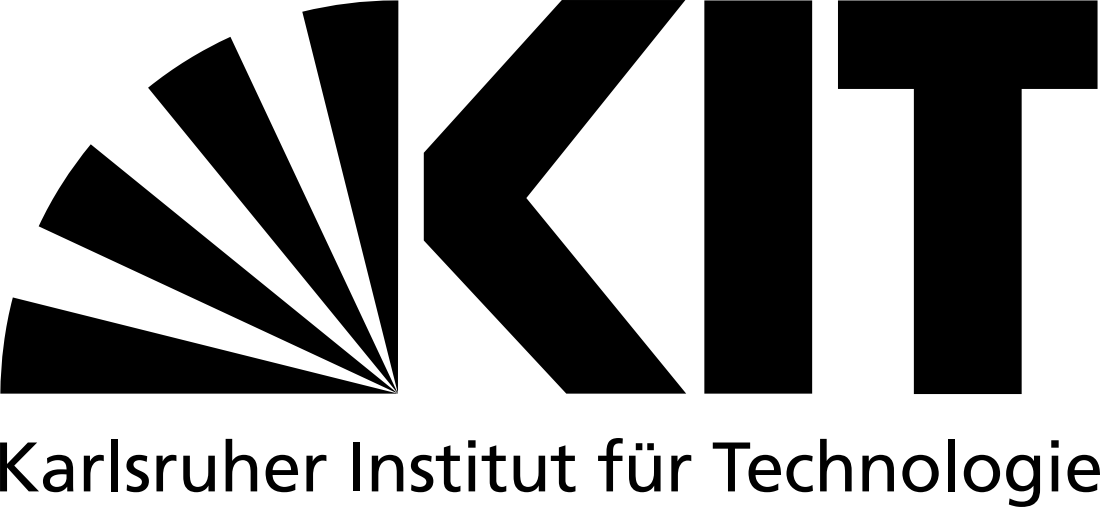
[picture p137: page 1]
