enggsajjad/coffeeMachine/BA/coffee/Thesis_Simon/presentation/KIT/kit_logo_de_4c_positiv.pdf

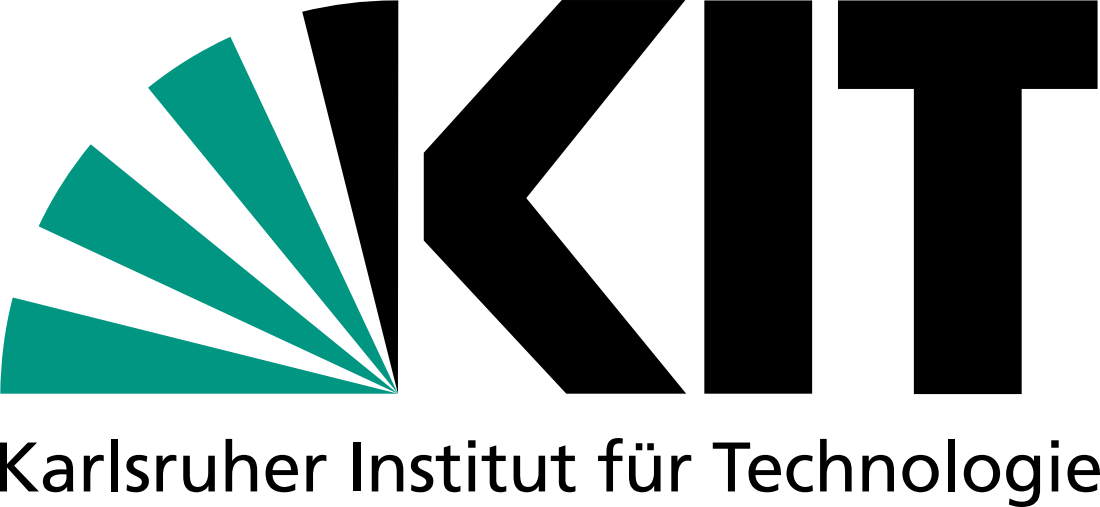
[picture p138: page 1]
