enggsajjad/coffeeMachine/BA/coffee/Thesis_Simon/presentation/KIT/kit_logo_en_1c_schwarz.pdf

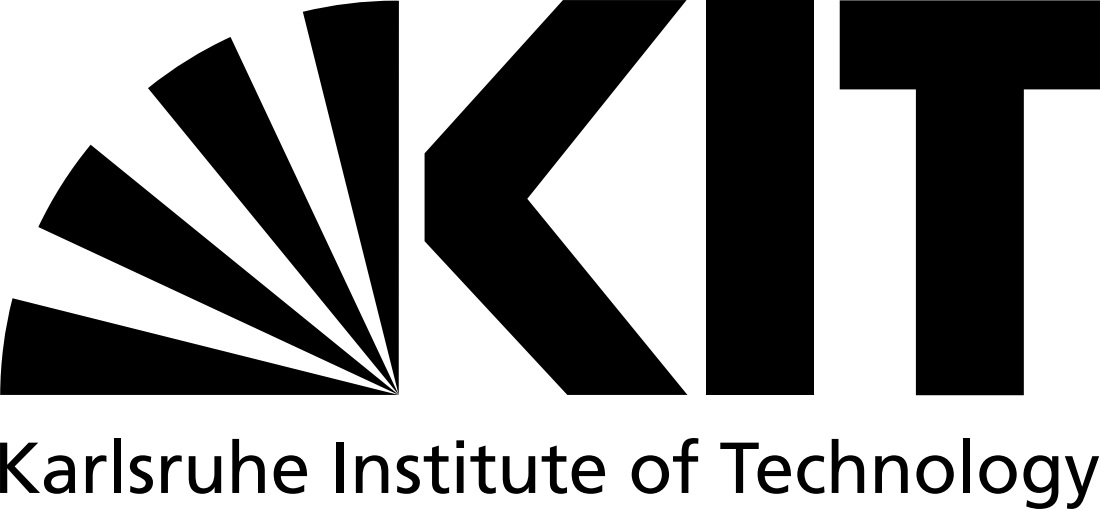
[picture p139: page 1]
