enggsajjad/coffeeMachine/BA/coffee/Thesis_Simon/presentation/KIT/kit_logo_en_4c_positiv.pdf

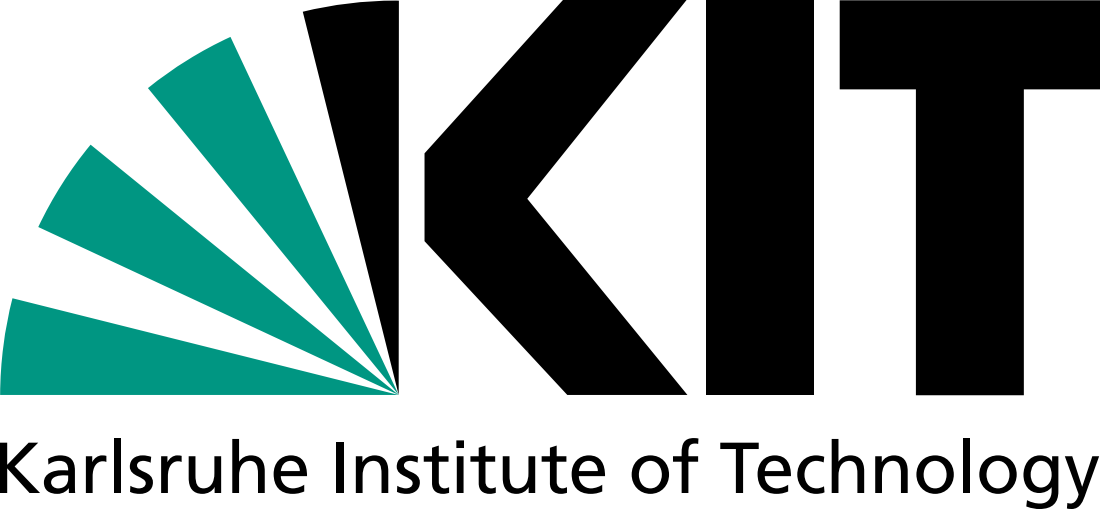
[picture p140: page 1]
