enggsajjad/coffeeMachine/BA/coffee/Thesis_2017_Karim_Ben_Ammar/Code/UI/config.txt

Water switch : 35, IN
Water flow 1 : 29, IN
Water flow 2 : 31, IN
Grinder : 33, IN
