enggsajjad/coffeeMachine/BA/coffee/Thesis_Simon/presentation/images/IMG_20200115_153617.jpg

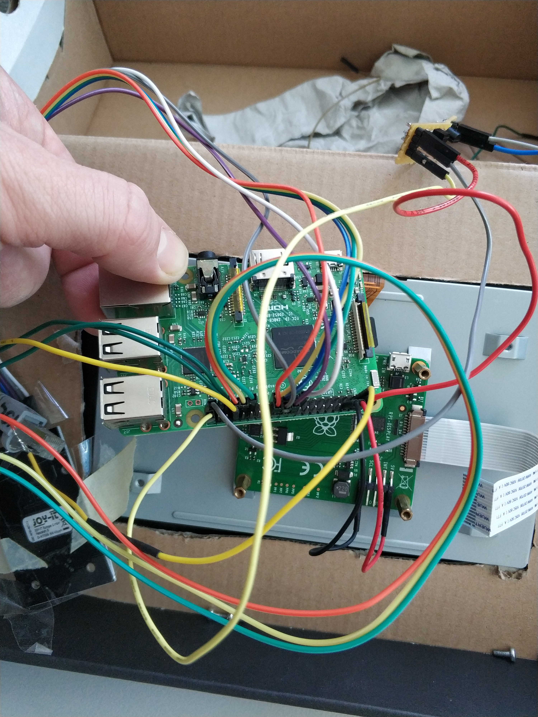
BA/coffee/Thesis_Simon/presentation/images/IMG_20200115_153617.jpg
